davidg5678/HP-Prime-IPS-LCD-Mod-FPGA/PROGRESS.md

# Progress

Update this file at the end of each work session so a future session (human or agent) can
pick up cold. Newest entries at the top.

## 2026-08-07 — BACKLIGHT DIMMING WORKS. The "PWM dimming is impossible" claim was wrong.

**Status: observed on hardware — at 200 Hz the backlight dims smoothly across the entire sweep,
duty 255 down to 8, and looks good at every level.** User's words: *"Dimming works and looks good at
all levels, but panel never goes completely dark; it just gets pretty dim."* No flicker reported.

```
make pass-hw BLHZ=200 SWEEP=1

 duty     %   on-time          observed
  255  100%    4988 us         bright
  128   50%    2503 us         |
   64   25%    1251 us         |  smooth, good at every step
   32   13%     625 us         |
    8    3%     156 us         dim, still lit
```

### What this overturns

Three documents carried "**PWM dimming does not work on this board**", derived from a single
measurement: 1 kHz, 25% duty, dark. That is now definitively false as a statement about the board.
The frequency was never the fixed thing — it was just never varied.

The cost of the original phrasing was real: it made `BL_DUTY_INIT` a binary choice between 0 and
255 for two sessions, and produced a shipped default that powered the box up dark.

### And it leaves a contradiction, recorded rather than explained away

The model that justified the fix was *minimum usable duty ≈ soft-start / period* — lengthen the
period and the on-time clears soft-start. **The data does not support that model.**

```
FAILED (2026-08-04):   1 kHz, 25% duty  ->  250 us on-time  ->  dark
WORKS  (2026-08-07):   200 Hz, duty 8   ->  156 us on-time  ->  lit
```

**The working case has a SHORTER on-time than the failing one.** So on-time versus soft-start cannot
be what distinguishes them. Either some other variable does — off-time, the converter's shutdown
behaviour between cycles, C54's discharge through a non-linear LED string — or the original
observation was mistaken. That session was the same one that fixed the reversing FFC and had a
misread meter, so a bad reading is not implausible.

**The re-test at 1 kHz was attempted and did not run** (`make pass-hw BLHZ=1000 SWEEP=1` — the board
had been disconnected). It is a 30-second experiment and it is the single thing that would settle
this. Do it before writing any explanation into the docs; the whole point of this entry is that the
last explanation was written from one data point and was wrong.

### Open, in priority order

- **Re-run the 1 kHz sweep.** Resolves the contradiction above. If 1 kHz now dims fine, the original
  observation was simply wrong and the frequency control is a convenience rather than a fix. If it
  is genuinely dark, there is a real frequency threshold worth finding by bisection.
- **`BL=0` full-off is not observed.** The sweep stops at duty 8. The RTL forces the pin low when
  `bl_duty == 0` (`bl_on = bl_ready && (bl_duty != 8'd0)`), so it should be a true off, but "should
  be" is what this entry is about. One command confirms it.
- **The low end is coarse and perceptually uneven.** Duty is 8-bit, so the bottom of the range steps
  8 -> 4 -> 2 -> 1 in ~doubling jumps of *perceived* brightness, since perception is roughly
  logarithmic. Two independent improvements: widen the PWM duty to 12 bits for resolution near
  zero, and apply a gamma curve (host-side is enough — map a 0..255 user level through
  `(level/255)^2.2`) so equal control steps feel equal. This is what would turn "good at all levels"
  into even control.
- **LED current is STILL unmeasured**, now at every duty. The panel wants 19.2 V at 40 mA, abs max
  50 mA. Dimming makes the design safer, not verified.
- Analog dimming via an RC-filtered PWM into the `FB` node stays available as a hardware option, but
  on this evidence **it is not needed** — which was the question worth answering before designing a
  PCB around it.

## 2026-08-04 (part 3) — full frame rate, a 19x faster sim loop, and an FPGA playbook

**Status: the standalone box is finished. Flashed, boots into the live passthrough by itself with
the backlight on, at the FULL source rate.** `make pass-hw` →
`PASS: passthrough emitting 320x240 in 371x260 at 62.2 Hz (62.2 fps wall-clock); source 320x240 at
37.3 fps, LIVE PASSTHROUGH on the panel`. New: `make simq` (Verilator), `sim/targets/passthrough_slow`,
`docs/fpga_project_playbook.md`, triple buffering.

### Verilator: the inner loop got 19x faster, for free

`verilator --binary --timing` compiled `tb_passthrough` **first try**, no source changes, only
`-Wno-fatal` to get past pre-existing lint warnings. `#delay`, `fork`/`join`, `wait()`, hierarchical
`dut.x` references, the tristate SDRAM bus and `$fatal(1)` all worked.

```
iverilog + vvp        4 m 29 s
verilator --binary        14 s      <- identical verdict, 47/47 checks
```

`make simq` is the new inner loop; **`make sim` keeps its meaning unchanged** as the reference. Both
are kept deliberately, for the reason `CLAUDE.md` already gives about iverilog vs GowinSynthesis:
independent tools disagree about what legal Verilog is, so their *agreement* is evidence. Same
argument as `make build-oss`.

This single change is what made everything below affordable — the slow-regime testbench that found
the buffering bug is 350 ms of simulated time, which is minutes under Icarus and seconds under
Verilator.

### The verification gap closed, then the bug fixed

`sim/targets/passthrough_slow` runs the source at the Prime's **real frame rate** (1361 DOTCLKs ×
259 lines = 26.53 ms = 37.70 Hz) with reduced active height — the opposite trade from the sibling
testbench, which keeps real line timing but ends up running the source ~5x FASTER than the panel.

Written to assert the behaviour **wanted**, not the behaviour produced, so it failed first:

```
source emitted 6 frames, DUT captured 3
FAIL: captured 3 of 6 source frames (50.0%)
```

That is the hardware bug, reproduced in 33 seconds, having previously needed a calculator, a panel
and a host wall-clock to notice.

**Fixed with a third buffer.** Three roles — `rbuf` on screen, `wbuf` filling, `dbuf` complete and
pending — with a three-way rotation when both frame boundaries land on the same clock, which the
two-buffer design could prove impossible and this one cannot. `wr_active` now never clears once
armed: the writer always has somewhere to go.

Measured on hardware: **18.9 fps → 37.4 fps.** Every source frame captured.

The old invariant (`wr_active` and `wdone` never both set) was retired with the scheme it described.
Worth noting it **held perfectly** right up to the moment hardware showed half the frames were being
dropped — a true invariant is not the same as a sufficient one. Its replacement is stronger:
`rbuf`, `wbuf` and (while pending) `dbuf` are always three distinct buffers, asserted every clock in
both testbenches.

### The timing margin was luck, and the build gate proved it

Adding the third buffer **failed the build**: 3 violated setup endpoints, Fmax 105.2 MHz against a
108 MHz constraint. All three violations were the path flagged in part 2 — the horizontal counter
through `test_pattern`'s combinational logic into the output register. Diagnostic scaffolding was
setting Fmax for the whole design.

Fixed by fencing `test_pattern` with registers on **both** sides. Free, because its output is
sampled only on `tg_tick`, one cycle in eighteen; and safe for a reason worth stating rather than
assuming — `tick` is a one-cycle pulse at the last phase and `nxt_x`/`nxt_y` change only just after
it, so they are stable for the 17 cycles preceding every tick.

```
two buffers, no pipeline     108.423 MHz    (36 ps -- placement noise)
three buffers, no pipeline   105.172 MHz    BUILD FAIL, 3 violations
three buffers, output reg    108.677 MHz    passes, 0.6% margin -- still luck
three buffers, both sides    117.721 MHz    9% margin, logic depth 8 -> 6
```

Registering only the output was not enough: it split the path but left the counter→pattern half
still setting Fmax. **`make build`'s timing gate is the only reason any of this was noticed** — the
vendor tool exits 0 and writes a bitstream regardless.

### `docs/fpga_project_playbook.md`

A board- and vendor-agnostic distillation of everything this project learned, written to be copied
into a new repo: layout conventions, the PASS/FAIL contract, the two-simulator strategy, the
runtime-mux convention and how to choose its power-on default, build gating, telemetry design, the
classes of board trap that cost time here, debugging discipline, and how to work with an agent on
hardware. `docs/verification.md` remains the project-specific version of the same argument.

### Backlight: 0 → 255, and why the earlier reasoning was incomplete

Part 2 set `BL_DUTY_INIT = 0` to avoid enabling a boost into a load that cannot be detected. Correct
for `lcd_panel`, a bench tool where panels come and go — but it meant the flashed box **powered up
dark and needed a computer to light it**, defeating the point.

The step missed the first time: **pin 49 has a 27 kΩ pull-up, so the boost is already enabled by
every bitstream that does not drive that pin**, including an unconfigured FPGA. "Boost on" is the
board's resting state; 255 just reaches it deliberately, and 250 ms after video starts per the
panel's T2. Now `8'd255`, and the testbench asserts the shipped value is never in the **forbidden
1..254 range** — the range that produces a dark panel reporting itself lit.

### Three testbench bugs, all one class

All three were **comparing quantities that live on different time bases**, and all three produced
failures while the RTL was correct:

1. `dut.mode_real` point-sampled after a pin-observed frame count — internal state changes cycles
   before the pins show it. Fixed by accumulating over the window the pins define.
2. A pixel-check window opened mid-frame and closed at the next VSYNC, so it could land entirely in
   blanking: `0 pixels checked` while everything else passed. Fixed by aligning to a boundary first.
3. Source-frame counters compared across the sampler's lag, giving `7 of 6` and then `6 of 5` —
   *opposite* directions, the signature of a window straddling a boundary. Fixed by reading both
   counters 1 ms after a boundary, far outside the lag and far inside a frame.

### Open

- The **two-buffer** rate limitation is fixed; nothing known is outstanding on the passthrough.
- `sim/targets/passthrough` still runs the source faster than the panel. That is now a deliberate
  division of labour with `passthrough_slow` rather than an oversight, and both are documented as
  such — but note that neither runs a *full-height* source, so the writer still only addresses
  `y < 8`.
- The RGB LED cannot be silenced (pin 79 is `probe[8]`); the LED row defaults on where `lcd_panel`
  defaults off. Both cosmetic.
- `python/tools/lcd_panel.py`'s docstring still claims 25% PWM default — stale since Phase 3.

## 2026-08-04 (part 2) — PHASE 4 COMPLETE: the HP Prime's screen is live on the replacement panel

**Status: the passthrough works on hardware, first attempt, no debugging session. The calculator's
display is reproduced on the Orient Display AFY320240A0 in real time, entirely inside the FPGA —
the host is not in the video path at all.** `make pass-hw` →
`PASS: passthrough emitting 320x240 in 371x260 at 62.2 Hz (62.7 fps wall-clock); source 320x240 at
18.9 fps, LIVE PASSTHROUGH on the panel`. Visually confirmed: "the prime's screen is showing and
looks perfect."

**All four phases are now done.**

New this session: `python/tools/passthrough.py`, `make pass-hw`, AUTO mode, report v0x07.
`make sim SIM_TARGET=passthrough` → PASS, 43 checks. `make build BUILD_TARGET=passthrough` →
5524 paths, 0 setup / 0 hold, Fmax 111.0 MHz. `make build-oss` agrees.

### It worked first time, and the reason is worth naming

Nothing was debugged on hardware. Every question that *could* have been settled in simulation had
been, and the two that could not — is the panel wired correctly, is the calculator's flex actually
driving — had both been settled in earlier phases by the same discipline. The bring-up was three
commands and a look at the glass.

That is the payoff `docs/verification.md` argues for, measured: the phase that had the most moving
parts (capture + SDRAM + panel + rate matching + a runtime mux) cost the least hardware time of any
in the project, because the RTL arrived at the bench already correct.

The one thing simulation could not have caught was also the one thing that would have looked like a
hardware fault: `BL_DUTY_INIT = 64`, which produces a **dark panel while the report says the
backlight is on**. That was found by re-reading Phase 3's own PROGRESS entry rather than by any
tool. Fixed before first flash. **Use `BL=255`.**

### Two measurements taken at the bench, one benign and one real

**Runts: 26,933 — benign, and only after doing the arithmetic.** Over ~81 s the Prime emits
~1.08 x 10^9 DOTCLK edges, so that is **0.0025%**, roughly 15x *better* than the 130-per-frame rate
Phase 2 measured with `frame_capture`. A raw counter means nothing without its denominator, and
this one is alarming-looking on purpose-built display. Left as-is.

**Source frame rate is 18.9 fps against the Prime's 37.7 Hz — exactly half, and this one is real.**
Caught only because `passthrough.py` times the FPGA's own counter against host wall-clock; the
FPGA's internal view is perfectly self-consistent at 18.9.

Cause is architectural, not a coding slip. `ev_done` fires at the same instant as the *next* source
frame's `frame_start`. At that moment **both** buffers are occupied — one just filled and awaiting
the panel swap, one being displayed — so the writer cannot arm for the frame beginning right then,
and re-arms one frame later. It therefore captures every *other* source frame.

**This contradicts this file's own earlier claim that two buffers suffice.** That argument — "a
completed capture is always collected before the writer needs the buffer back" — is subtly wrong:
the writer needs a buffer *at the instant* the previous capture completes, which is necessarily
before any panel swap can have occurred. Reader-faster-than-writer makes the *collection* safe; it
does not make a buffer *available* at the frame boundary. Capturing every frame needs a **third
buffer**, and the SDRAM has room to spare (8 MB total, 150 KB per buffer).

Not a visible defect: the panel still refreshes at 62.2 Hz so there is no flicker, only the content
updates at 18.9 Hz, which a calculator UI does not stress. But it is half the available fidelity,
it was asserted to be otherwise, and simulation could never have found it — the testbench runs the
source *faster* than the panel, the inverse regime, where this effect does not arise.

### The design goal was restated, and it changed the default

The passthrough is meant to be a **standalone box**: calculator in, panel out, no computer. The
bitstream as written could not be one. `CLAUDE.md`'s mock-mode convention defaults the mux to MOCK
at power-on, so a flashed board would sit on a test pattern forever unless a host sent `0x52`.

**New third setting, `AUTO` (`0x41` = 'A'), and it is now the power-on default.** Mock pattern until
a captured frame has been *swapped* to the reader, then live passthrough, and it stays there. Forced
MOCK/REAL still override absolutely, so the convention's actual content — both paths in one
runtime-switchable bitstream — is untouched. Only the default moved.

AUTO also beats defaulting to plain REAL, and the reason is diagnostic rather than aesthetic:

| Calculator not driving | What you see | What you can conclude |
|---|---|---|
| default REAL | black panel | nothing — dead bitstream, unseated FFC, backlight at 0 and "no signal" are identical |
| **default AUTO** | **GRID pattern** | **FPGA, FFC, panel and output path are all good; only the calculator is missing** |

Two implementation details that mattered more than the feature:

- **It gates on `have_frame`, not `src_frames`.** `src_frames` counts frames the *writer* finished,
  one of which may still sit unswapped in `wbuf`. Switching on that would present a buffer the panel
  has not been handed. `have_frame` is set at `ev_swap`, so it means the *reader's* buffer is
  complete.
- **The effective mode is latched at the panel's frame boundary**, like the swap itself, so the
  changeover cannot tear a frame. That also buys a free frame of margin: `ev_swap` sets `have_frame`
  on a `tg_frame` edge, so the latch samples the pre-swap value on that edge and flips at the *next*
  one, by which point the reader has streamed the new buffer for a whole frame.

Cost: **3 registers and 2 LUTs.** The double-buffer machinery already existed; AUTO only gates it.

### A regression caught by reading Phase 3's own lesson back

`passthrough_top.v` shipped `BL_DUTY_INIT = 8'd64`, written the session *before* Phase 3 reached
hardware. `lcd_panel_top.v` was corrected to `8'd0` *by* that session. So Phase 4 still carried the
exact failure Phase 3 had already paid for: at 25% duty the LP3320 never clears soft-start, the
panel stays dark, **and the status report says the backlight is on**. First light would have looked
like a hardware fault.

Now `8'd0`, with the reasoning in the parameter comment so it does not get "helpfully" raised again.
The testbench reads the shipped duty back **off the wire** (`rpt[4] == 0`) rather than asserting
about the source, and deliberately does *not* override that parameter the way it overrides
`BL_DELAY_CYCLES`. **Use `BL=255`; intermediate values do not work on this board.**

### A testbench bug that failed while the RTL was right

One check failed: `effective mode still MOCK = 1, expected 0` — alongside `pixel mismatches = 0`
over all 76,800 pixels against the GRID oracle. Both readings were true, which is what made it
diagnosable: the frame displayed *was* mock, and the sample was taken late.

Cause: a point-sample of `dut.mode_real` taken after `wait (frames == f0+1)`. `frames` counts VSYNC
edges observed at the **pins**; `mode_real` is latched on the timing generator's **internal** frame
tick a few cycles earlier. **This is the same pin-versus-internal skew the testbench's own comment
already documents for `ev_swap`** — and it was reintroduced anyway, three months of notes later.

Fixed by not point-sampling at all: two sticky flags accumulate which effective mode was in force
while `lcd_de` was high, so the assertion covers every *displayed* pixel of the frame. That removes
the skew rather than compensating for it, and it is a stronger claim — a mode that flipped mid-scan
would now be caught too.

### Fmax moved 108.423 → 111.020 MHz *because logic was added*

Which cannot be a real speedup, and is the useful part. The critical path moved from
`u_tg/hc[10] → lcd_r[0]` to `u_tg/vc[5] → lcd_g[0]`, depth 8 → 7. Both are the **mock test
pattern's** combinational logic — diagnostic scaffolding — reaching the output register in one
cycle.

So the previous build's 36 ps of slack was **placement noise, not a structural limit**, and neither
number is a dependable margin: this design sits around 108–111 MHz with ~3% run-to-run variation
against a 108 MHz constraint. A future build that changes nothing could land at 108.0 and fail.
`test_pattern`'s output is only consumed on `tg_tick`, once every 18 cycles, so **a pipeline
register would take it off the critical path permanently** instead of leaving it to the placer.
Not done yet — recorded so the next timing surprise is not treated as new.

### `python/tools/passthrough.py` + `make pass-hw` — control and telemetry only

**It carries no pixels, and it is not needed for normal use.** Phase 2's UART streaming is retired,
not unfinished: it topped out at 2.0–2.6 fps because the ceiling was per-request latency, not bit
rate. The video path is internal and the host is not in it.

The tool exists for when AUTO *doesn't* light up, because the 24-byte report separates faults that
look identical on the glass. Report version bumped **0x06 → 0x07**: byte 5 now carries the
*requested* mode plus `have_frame`, while bit 2 of byte 2 carries the *effective* mode. Those two
disagreeing is the single most useful reading in the report — "requested AUTO, effective MOCK,
have_frame 0" means the calculator is not driving, which is a different fault from "effective REAL
with 0 source frames".

It also cross-checks the FPGA's frame counter against **host wall-clock**, the two-instruments
argument from `docs/prime_lcd_protocol.md`: a mis-locked PLL still produces self-consistent 371×260
frames, and only an independent clock catches that. Source-side geometry is **reported but never a
pass criterion**, so the tool still passes on a bench with no calculator attached — which is the
first bring-up step.

### Build health

- Gowin signoff: **5524 paths, 0 setup / 0 hold.** Logic 1386/20736 (7%), Register 895 (6%),
  **42/66 package I/O**, 1 rPLL, **0 BSRAM** (the three FIFOs went to logic).
- Setup analysed at **Slow 0.95 V 85 °C** — the worst-case corner, so the margin is real, if thin.
- Pins 88 (`MODE0`), 87 (`MODE1`) and 9 (`RECONFIG_N`) carry no signal. The four SSPI pins
  (53/54/55/56) *are* in use, which is exactly what `options.tcl` exists to allow.
- Four warnings, all read. Two are the documented pair (`PR1014` on `clk_d`, `NL0002` sweeping
  `test_pattern`). The other two are new and both correct:
  - `CV0018 probe[1] unused` — HSYNC, which `prime_pixel.v` documents as unused.
  - **`CV0020 probe[5:4] unused` — D0 and D1 of the Prime's bus.** RGB565 truncation drops red's
    bottom 3 bits, green's bottom 2 and blue's bottom 3, so D0 and D1 fall below *every* threshold
    and cannot reach any output. D2 survives only through green, which is why `probe[6]` is not in
    the warning. **The toolchain rediscovered the board's RGB565 wiring from the RTL alone.**
    Those two probe wires must stay physically connected regardless — `la_capture` and
    `frame_capture` share the harness and do use all 8 bits.

### Timings, for whoever optimises the loop next

`make build` is **8.9 seconds**. `make sim SIM_TARGET=passthrough` is **4 m 29 s**. The simulation
is ~34.5 M clock cycles at ~128 k cycles/s, which is ordinary `vvp` interpreter speed, and the cost
scales with *simulated time*, not with how many pixels are checked — each panel frame is 16.08 ms
= 1.7 M cycles ≈ 13 s of wall clock whether or not anything inspects it. Levers, in order of size:
Verilator `--binary --timing` (10–50×, already installed, untried); trimming settling waits (~30%);
splitting the testbench into a fast inner-loop target and a slow signoff one.

### Open

- **The passthrough captures every OTHER source frame (18.9 Hz, not 37.7).** Needs a third buffer;
  see above. Highest-value remaining change, and the SDRAM has the room.
- **The testbench runs the source FASTER than the panel — the inverse of reality.** Eight active
  lines in a 30-line frame repeats at ~325 Hz against the panel's 62.2 Hz, where the real
  calculator is 37.7 Hz. That exercises the frame-*dropping* path hard, which is the stricter
  direction for the swap invariant, but it means "two buffers suffice because the reader is
  strictly faster" is still **argued rather than demonstrated**. A second phase with
  `P_V_TOTAL ≈ 195` (a ~20 ms source frame, slower than the panel's 16.08 ms) would enter the real
  regime for ~60 ms of extra sim time. The PASS line previously claimed "37.7 Hz-class timing",
  which was true of the *line* and false of the *frame*; it now states the geometry it actually ran.
- **The writer only ever addresses `y < 8`.** Full-height addressing (`row_base` near `y = 239`) is
  arithmetically checked — 38,240 + 159 = 38,399 against `FB_WORDS` 38,400 — but never exercised.
- Fmax is placement-dependent at ~3% against a 108 MHz constraint; see above.
- The RGB LED **cannot** be silenced here (pin 79 is `probe[8]`), unlike `lcd_panel`. Expect it lit
  at some arbitrary colour; it is not a fault.
- The LED row defaults **on**, where `lcd_panel` added `CMD_LEDS` (`0x4C`) to default it off. Not
  ported.
- `python/tools/lcd_panel.py`'s docstring still claims the bitstream "comes up at 25% PWM duty" —
  stale since `BL_DUTY_INIT` went to 0 in Phase 3.
- **Consider `make flash BUILD_TARGET=passthrough` once it works on hardware.** Every power cycle
  currently reverts to `la_capture` in flash, which leaves pin 49 undriven and the backlight boost
  enabled by the board's pull-up. Persisting a bitstream that actively drives that pin makes the
  safe state the default — and makes the standalone box actually standalone.

### The bring-up sequence that worked — reuse it

```
make flash-sram BUILD_TARGET=passthrough
make pass-hw MODE=mock BL=255   # panel only: is Phase 3 intact inside the
                                # bigger bitstream? -> 371x260 @ 62.2 Hz, and
                                # src_frames was ALREADY climbing with
                                # 240 lines / 320 px, so the capture side was
                                # confirmed before the mux was ever switched.
make pass-hw MODE=auto          # hand control back -> effective mode REAL,
                                # reached without forcing. Prime's screen on
                                # the glass.
```

Forcing MOCK first is what made this three commands instead of a debugging session: it separates
"is the FPGA driving the panel correctly?" from "is the calculator driving?" **before** the two are
composed, and the report answers the second question while the panel is still showing the first.
That is the entire reason the capture path runs in both modes.

## 2026-08-04 — PHASE 3 COMPLETE: the panel is displaying

**Status: the physical Orient Display AFY320240A0 is lit and showing all eight test patterns at
320×240, driven from `src/targets/lcd_panel`. `make lcd-hw` → `PASS: lcd_panel emitting 320x240 in
371x260 at 62.2 Hz`.** Phase 3 is done.

### What fixed it, and what that confirms

A **reversing (type A ↔ type B) 40-pin 0.5 mm FFC**. Nothing in the FPGA changed. That was the one
pre-flight check `docs/panel_afy320240a0.md` had flagged as impossible to settle from the schematic,
and it was the only thing wrong.

Because the whole signal chain now works end to end, a lot is confirmed at once that could not be
checked any other way:

| Confirmed by the panel actually working | Would have failed how |
|---|---|
| Bit order across the connector (descending pin number as vector index ascends) | plausible-looking wrong colours |
| RGB565 channel wiring, all three channels | swapped or dead channel on BARS |
| DE gating and the 320×240 active window | missing border line on GRID |
| Thbp = 43 with Thw nested inside it | image sitting 4 px off |
| **DCLK polarity — the quarter-period phase offset works** | corrupt pixels, or smear on CHECKER |

That last row is the one worth dwelling on. The datasheet's polarity could not be read off the
scanned figures and `DPOL` is unreachable because the board grounds the panel's CS. Rather than
guess, `lcd_timing_gen` places DCLK's edges 4 and 13 phases from the data transition so the design
is correct on *either* edge. It works, and it would have worked had the polarity been the other way.

### The backlight PWM does not work, and now we know why

**Measured, from both directions.** The LP3320's enable is PWMed at ~1 kHz, so 25% duty is a 250 µs
on-time — shorter than the converter's soft-start. It never reaches regulation and the panel stays
dark **while the status report says the backlight is on**, which is the worst combination.

Both ends of the evidence:

- It lit immediately when the board reverted to `la_capture`, a bitstream that does not drive
  pin 49 at all — leaving the board's 27 kΩ pull-up to hold `EN` statically high.
- It lights at `BL=255` (99.6% duty, effectively static).

So `BL=255` is the working setting, and `BL_DUTY_INIT` stays 0: a default that reports "on" while
producing no light is worse than one that reports off. Restoring dimming means raising
`PWM_PRESCALE` until the on-time comfortably exceeds soft-start (~200 Hz gives 1.25 ms at 25%), then
walking the duty down on hardware to find where it drops out. **Left unchanged rather than altered
on a guess** — the LP3320 datasheet would settle it properly.

### Open

- **Phase 4** (`src/targets/passthrough/`) is the remaining work: written, passes simulation end to
  end, never synthesised. Now unblocked — the panel it drives is known good.
- Backlight dimming, as above. `BL=255` works; intermediate values do not.
- Consider `make flash BUILD_TARGET=lcd_panel` to persist. Every power cycle currently reverts to
  `la_capture` in flash, which leaves pin 49 undriven and the backlight boost enabled by the
  board's pull-up. Persisting a bitstream that actively drives that pin makes the safe state the
  default.
- LED current is still unmeasured at `BL=255`. The panel wants 20–40 mA, abs max 50 mA.

## 2026-08-03 (part 5) — PHASE 3 ON HARDWARE: FPGA side confirmed. Panel dark — A/B FFC mismatch.

**Status: `make lcd-hw` → `PASS: lcd_panel emitting 320x240 in 371x260 at 62.2 Hz`, on real
silicon, first flash. The panel itself displays nothing, and the cause is now known and is not in
the FPGA: the panel's FFC and the Tang Nano's J2 are opposite contact types (A vs B), confirmed
with a multimeter. Fix is a reversing 40-pin 0.5 mm FFC.**

### The FPGA side is right, measured two independent ways

```
h = 320/371   v = 240/260        exactly the datasheet typical column
line 61.8 us (spec 55-65)        frame 62.2 Hz (spec ~58-68)
measured 62.8 fps over 0.51 s    <- host wall-clock, independent of the above
```

The last line is the one that matters. 62.2 Hz is *derived* from edges the FPGA counted on its own
output pins; 62.8 fps is timed by the host against real time. A mis-locked PLL or a miscounting
phase generator would still produce self-consistent 371x260 frames — only comparing against
wall-clock catches it. Same two-instruments argument `docs/prime_lcd_protocol.md` uses for the
Prime's frame rate.

### The pre-flight check that mattered was the one flagged as unverifiable

`docs/panel_afy320240a0.md` listed three checks needing eyes on hardware, first among them FPC
contact orientation, with the note that it "cannot be settled from the schematic". That is exactly
what failed. Nothing else was wrong.

### Three things learned about the board, all of them traps

- **Pin 49 (backlight enable) has a 27 kΩ pull-up to +3V3 on the board** (R29), with the FPGA
  driving through R30 = 100 Ω. So the LP3320 boost is **enabled by default** and only an actively
  driven low turns it off. `PULL_MODE=DOWN` in a `.cst` does not help — an internal ~50 kΩ pulldown
  loses to an external 27 kΩ pull-up. **Any bitstream that does not drive pin 49 leaves the
  backlight converter enabled**, including `la_capture`, `frame_capture` and an unconfigured FPGA.
- **The onboard WS2812 latches its colour and holds it.** Leaving pin 79 unassigned lets the data
  line float, pick up noise and latch some arbitrary bright colour; tying it low does not clear it,
  because a permanently low line is just an endless inter-frame gap. The only fix is to *send* 24
  zero bits — hence `src/common/ws2812_off.v`. **Pin 79 is also `probe[8]` (the Prime's D4)**, so a
  capturing target cannot silence this LED.
- **A status report of `a5 02 …` in 10 bytes means the board reset.** SRAM configuration is
  volatile, and the onboard flash still holds `la_capture` (report version 0x02, 10-byte header)
  from an earlier session. Any power blip silently swaps the running design for that one, and the
  symptom is a truncated reply rather than a dead link. Free diagnostic; worth knowing.

### Changes made

- `src/common/ws2812_off.v` — continuous zero frames, holds the RGB LED dark.
- Status LED row now **defaults off**, runtime-switchable with `0x4C 'L'` (`make lcd-hw LEDS=on`).
  `leds[0]` keeps its ~1.6 Hz heartbeat unconditionally: `docs/verification.md`'s argument for a
  liveness indicator is that it must work when the serial link does not, and an all-dark board
  cannot be told apart from an unconfigured one.
- **`BL_DUTY_INIT` changed from 64 to 0 — the backlight is now opt-in.** The original reasoning
  ("start dim, it is the cheap direction to be wrong in") missed the case where no panel is mated:
  the LP3320 takes its feedback from R31 in series with the panel's LED string, so with no LED
  current FB never reaches threshold and the converter drives to maximum into an open circuit.
  A display driver must not enable a boost into a load it cannot detect, and nothing on the 40-pin
  connector reports back. The testbench pins the shipped default at 0 while overriding it to 64 so
  the PWM duty measurements still have edges to measure.

### Two wrong turns, recorded because both cost time

- **A truncated status reply was diagnosed as a brownout caused by the backlight.** It was not —
  the board had been power-cycled manually between trials and had reconfigured from flash. The
  reading that settled it was the raw reply bytes (`a5 02 30 …`), not any amount of reasoning about
  boost converters. Dump the bytes first.
- **A misread meter (2.66 A, actually 2 W ≈ 400 mA) triggered a damage scare and an emergency
  power-down.** Nothing was damaged. The arithmetic that should have been done immediately: all six
  indicator LEDs plus a full-white WS2812 come to ~0.12 A, so LEDs could never have explained
  2.66 A — but they explain 400 mA fine.

### Can the FFC mismatch be fixed in software, or worked around with jumper wires? No, and partly.

Both asked and both answered from the datasheet's Pinout diagram (page 5), now recorded in
`boards/tangnano20k/pinout.md`.

**Flipping in software is impossible**, and for a power reason rather than a signal one. A flipped
cable mates board pin *N* with panel pin *41−N*, which lands the panel's VDD on FPGA pin 15, its
19 V backlight anode on FPGA pin 17, and its ground on FPGA pin 38. A `.cst` can reassign which pin
carries which *signal*; it cannot make an I/O pad supply a rail.

**Jumper wires from the headers are possible but constrained.** The headers expose 34 free IOs, 31
usable after excluding the three BL616 pins. But **the entire green channel (32–37) and the top
three red bits (38/39/40) are not on the headers at all** — they exist only at the FFC socket, so
other header IOs would have to be reassigned to them. Full RGB565 + sync + backlight is 25 of 31,
which leaves too few for Phase 4's twelve probes; RGB444 fits both. And `VLED+`/`VLED-` are *only*
at FFC positions 1/2, so a header-wired panel has no access to the board's 19 V boost and needs an
external constant-current driver. `3V3` and `GND` are on the headers, so panel VDD is fine.

Conclusion: the reversing FFC is the cheaper and strictly better fix — it keeps 16-bit colour, the
onboard backlight supply, and Phase 4's probe budget.

### PHASE 4 also landed this session: `src/targets/passthrough/`

Written and passing simulation end to end, **not synthesised and not run on hardware**, parked
behind Phase 3's panel. New: `src/common/prime_pixel.v`, `src/targets/passthrough/`,
`sim/targets/prime_pixel/`, `sim/targets/passthrough/`.

```
PASS: passthrough -- 320 x 8 source pixels captured from a 1361-DOTCLK line at 37.7 Hz-class
timing, buffered in SDRAM and re-emitted exactly on 371 x 260 panel timing at 62 Hz, mux verified
in both directions, 0 overruns, 0 underruns
```

- **`prime_pixel`** turns `dotclk_sampler` output into addressed RGB565 pixels, resetting the
  component phase on the DE rising edge. Its unit testbench decodes a full 320×240 frame at real
  Prime timing — 76,800 pixels, 0 value errors, 0 coordinate errors, 0 runts — in 5 s, using
  Phase 1's `video_timing_gen` as an independent implementation of the protocol.
- **Double buffering exchanges at the panel's frame boundary**, so no frame tears. Two buffers
  suffice *only* because the panel (62.2 Hz) is strictly faster than the calculator (37.7 Hz);
  the invariant that encodes this (`wr_active` and `wdone` never both set) is asserted on every
  clock rather than reasoned about once.
- **Rate budget: 1.45 MW/s writer + 2.39 MW/s reader = 3.84 of ~10.8 MW/s.** No burst mode needed,
  which is the measurement `docs/sdram.md` asked for before optimising.
- Buffers sit in different SDRAM *banks* (stride 2^19) — irrelevant to today's single-word
  controller, but it is the layout an open-row policy would need.
- An in-flight SDRAM read is explicitly discarded across a frame restart (`rd_discard`). That is
  the exact class of bug left open in Phase 2's `frame_stream`, so it was handled rather than
  assumed away.

### Open

- **Waiting on a reversing (type A ↔ type B) 40-pin 0.5 mm FFC.** Everything else is ready.
- The PWM-on-a-boost-enable question is still unresolved: at 25% duty / 1 kHz the on-time is 250 µs
  and the LP3320's soft-start is unknown, so "dim" may simply not be reachable. Untested — the one
  full-duty trial ran into an open circuit, which proves nothing about the loaded case. The LP3320
  datasheet (FB reference, soft-start, current limit, OVP) would settle both this and what current
  R31 = 5.6 Ω actually sets.
- Phase 4 (`src/targets/passthrough/`) is written and passes simulation end to end — Prime →
  SDRAM → panel, 0 overruns, 0 underruns — but is **not synthesised and not run on hardware**, and
  is parked until the panel is confirmed working. Note it cannot silence the RGB LED (pin 79 is a
  probe there).

## 2026-08-03 (part 4) — PHASE 3: panel driver written and verified in simulation. No hardware yet.

**Status: `make sim SIM_TARGET=lcd_timing_gen` and `SIM_TARGET=lcd_panel` both PASS; `make build
BUILD_TARGET=lcd_panel` → 2201 paths, 0 setup / 0 hold; `make build-oss` passes. All eight
simulations in the repo pass. NOTHING HAS BEEN RUN ON THE PANEL — it was not connected during this
session.** New: `src/common/lcd_timing_gen.v`, `src/common/test_pattern.v`,
`src/targets/lcd_panel/`, `sim/targets/lcd_timing_gen/`, `sim/targets/lcd_panel/`,
`python/tools/lcd_panel.py`, `make lcd-hw`.

### Why Phase 3 now, ahead of finishing Phase 2's streaming

The decision was made on bandwidth. Streaming frames to the host maxed out at 2.0–2.6 fps at
1 Mbaud even after 4.6x RLE, and the measurements in part 3 showed the ceiling was per-request
latency, not bit rate — raising the baud rate to 3 Mbaud made it *worse*. The internal path is
108 MHz x 32 bits = 432 MB/s. Static captures already prove the protocol is understood
(`docs/prime_lcd_protocol.md` is complete and every figure in it is measured), so the remaining
value is in the passthrough, which never touches the host.

**This defers the "frames after the first are partial" bug rather than fixing it.** That bug is in
the capture re-arm path, not in the UART — the evidence in part 3 rules out host decoder speed,
padding, VSYNC re-trigger and stale `fetch_pending`. Phase 4 re-arms per frame continuously, so it
is likely to resurface there. Recording it here so a future session does not assume the phase
change made it go away.

### Two numbers that were not in `docs/panel_afy320240a0.md` before

The datasheet's AC tables are **images**, so `pdftotext` returns nothing for them and the existing
panel analysis was derived from the totals. Reading pages 10–13 visually confirms every derived
figure and adds the two pulse widths:

| | Min | Typ | Max | |
|---|---|---|---|---|
| Thw (HSYNC pulse) | 2 | **4** | 43 | DCLK |
| Tvw (VSYNC pulse) | 2 | **4** | 12 | HSYNC |

The SYNC-mode diagram on p.11 also settles directly what the arithmetic had only implied: **Thbp is
measured from the HSYNC falling edge and Thw is nested inside it.** Same for Tvw inside Tvbp. Get it
backwards and the image sits 4 pixels off with no other symptom.

### The one real design decision: DCLK is phase-shifted a quarter period

Every timing figure in the datasheet labels the clock "DCLK (Negative Polarity)", but the figures
are low-resolution scans and which edge the panel latches on cannot be read off them with
confidence. Normally you would set DPOL over the SPI — which is unreachable, because the board
grounds the panel's CS pin and a command only latches on CS's *rising* edge.

Guessing is a coin flip with a catastrophic wrong side: data changing *at* the sampling edge
corrupts every pixel. So instead, data transitions at phase 0 of the 18-cycle DCLK period and the
clock's two edges sit at phases 4 and 13:

| | setup | hold |
|---|---|---|
| falling edge (phase 4) | 37.0 ns | 129.6 ns |
| rising edge (phase 13) | 120.4 ns | 46.3 ns |

The spec is 12 ns for both. The worst of the four is **3.1x** the requirement, so the design is
correct on either polarity, and duty stays exactly 50% against a 40–60% spec. This is only
affordable because 6 MHz is slow — one DCLK is 18 system clocks, so quarter-period granularity is
free. It would not work at 108 MHz.

### Four bugs, two in the RTL and two in the testbenches

1. **DCLK went out of spec at power-on.** With the phase counter held in reset, DCLK parked high
   and the first period after release was stretched by the full reset length — 203.7 ns measured
   against a 200 ns maximum, and the real power-on reset is 32768 cycles, so on hardware that first
   period would have been ~304 µs. Fixed by letting the phase generator free-run from
   configuration and resetting only the video counters; the anomaly becomes a long *line* at
   power-on instead, which is ordinary. Caught because the testbench records the **maximum** period
   as well as the minimum — checking only "the period is 166 ns" would have passed.
   Cost, documented in the module: DCLK toggling is no longer evidence the design is out of reset.
2. **The status report's "active DCLKs per line" was latched on blanking lines too**, so it read 0
   whenever the host's request happened to land during vertical blanking — a `make lcd-hw` that
   passes or fails on timing luck. It surfaced as "active DCLKs = 0" alongside a correct "active
   lines = 240", a contradiction that could only come from the latch condition rather than the
   counter.
3. **Testbench: the reply was read after the request was fully sent.** The FPGA turns a status
   request around in a few 108 MHz cycles, so the first reply start bit had already passed by the
   time the receiver looked for it. Fixed by forking the receiver before the request goes out.
   Worth knowing this is a host-side hazard too — pyserial's buffering hides it, which is why
   simulation was the cheaper place to find it.
4. **Testbench: the backlight duty window ended exactly on a falling edge**, and whether the
   accumulator process or the task's stop-measuring assignment ran first is undefined in Verilog.
   It reported exactly half the true duty — convincing enough to be mistaken for a real divide-by-2
   in the RTL. Fixed by walking edges inside a single process.

### Mutation-tested, per `docs/verification.md`

Five deliberate breaks, all caught, each with a diagnostic naming the actual fault:

| Mutation | Caught as |
|---|---|
| `DCLK_FALL` 4 → 1 | `worst setup = 9.260 ns` (spec 12) + duty out of range |
| `DCLK_RISE` 13 → 18 (edge lands on the data change) | `worst hold = 0.000 ns` |
| `H_FRONT` 8 → 7 | `Th = 370, expected 371` and `Thfp = 7, expected 8` |
| `H_SYNC` 4 → 43 (sync no longer nested in the back porch) | `Thw 43 is not nested inside Thbp 43` |
| `DCLK_FALL` 4 → 0 | degenerate — the comparison never matches, DCLK stops, watchdog fires. Not a useful mutation; replaced with the two above |

### Verification structure

Two testbenches, deliberately split:

- **`sim/targets/lcd_timing_gen`** — the AC table at full size, in the datasheet's own units: DCLKs
  between HSYNC falls, HSYNC falls between VSYNC falls. Nothing reads `hc`/`vc`/`ph` inside the
  DUT. 6 s.
- **`sim/targets/lcd_panel`** — everything *between* the modules: all 76,800 active pixels of a
  frame compared against an oracle written from `test_pattern.v`'s documented spec (not copied from
  its code), the bus asserted to be 0 outside DE, the command channel driven over a bit-banged
  1 Mbaud UART, and the status report cross-checked against what the testbench measured off the
  same pins. It also fires `CMD_RESET` **mid-frame** and re-checks the full geometry and all 76,800
  pixels afterwards — that is the only test of `lcd_timing_gen`'s deferred restart, which holds a
  restart request until the next DCLK tick precisely so the outputs never move at an arbitrary
  phase. 60 s.

The top-level testbench overrides `BL_DELAY_CYCLES` to something a simulation can afford, and then
asserts the *shipped* default is ≥ 250 ms via a second, deliberately-never-clocked instance — so
"shrunk for simulation" cannot quietly become "shrunk on hardware".

### Numbers

- Gowin signoff: 2201 paths, 0 setup / 0 hold. 719 logic (4%), 396 registers (3%), **30/66
  package I/O**.
- Every one of the 30 pins checked against the report's Function column: no `MODE*`, `DONE`,
  `RECONFIG_N`, `READY` or `JTAGSEL_N` among them.
- **All banks now report `BankVccio 3.3`**, where previous builds showed pins 25–42 as `LVCMOS18`.
  That confirms `boards/tangnano20k/pinout.md`'s claim that the 1.8 V reading was the tool's
  default for banks holding *no assigned I/O*, not the board.
- 18 output registers were placed in IOBs, which helps output skew for free.
- Two build warnings, both read: `PR1014` on `clk_d` (expected, documented, the 27 MHz hop into the
  PLL) and `NL0002` "module test_pattern is swept in optimizing" — module-boundary flattening, not
  logic removal; 719 LUTs is far more than a bare timing generator plus UART.

### Open — all of these need the panel physically attached

- **Nothing has been driven into a panel.** Everything above is simulation plus two clean builds.
- **DCLK polarity is still unknown**, and by design it does not matter. If pixels smear anyway,
  `DCLK_FALL`/`DCLK_RISE` in `lcd_timing_gen` are the two parameters to move.
- **DISP (connector pin 31) is hard-tied to +3V3 on the board**, so the datasheet's `T1 ≥ 10 ms`
  between internal reset and DISP is very likely violated. Commodity boards do this routinely. If
  the panel fails to initialise, cutting that trace and driving DISP from pin 52 — the one spare
  FPGA pin — is the first thing to try.
- **Backlight current is unmeasured.** The panel wants 19.2 V at 40 mA, absolute max 50 mA; the
  board's driver was designed for Sipeed's 4.3" panel. The bitstream comes up at 25% PWM duty
  deliberately. Measure on pattern 4 (WHITE) before raising it.
- **FFC contact orientation is unverified** — both connectors are 40-pin 0.5 mm, but the contact
  face needs eyes on the hardware. If it is wrong the fix is a flipped FFC extension, not an
  adapter.
- Phase 4 composes this with `frame_capture`: it will need `options.tcl` (the SSPI pins for the
  probes) and a frame buffer in SDRAM, and it inherits the part-3 partial-frame bug noted above.

## 2026-08-03 (part 3) — LIVE STREAMING: first complete frame streams, later frames partial

**Status: `make stream-hw` → `PASS: live stream, 8 frames decoded at 2.56 fps, 0 truncated`.
The first frame of every run is a complete 320x240 (76,800 px, 100%); subsequent frames arrive
but are partial. Root cause not yet found — see Open.** All seven simulations pass. New:
`src/common/pixel_rle.v`, `src/targets/frame_stream/`, `sim/targets/frame_stream/`,
`python/tools/frame_stream.py`, `make stream-hw`.

### Measurement decided every part of the design

| Question | Measured answer |
|---|---|
| Raise the baud rate? | **No.** 3 Mbaud gives 79 KB/s, 1 Mbaud gives 81 KB/s — per-request latency (~74 ms per 8 KB) dominates, not bit rate. Host also rejects >3 Mbaud outright. |
| Continuous push at 3 Mbaud? | **Loses 65% of bytes** — the FPGA outruns the host. At 1 Mbaud the FPGA is the slower party, so a continuous push cannot overrun and needs no flow control. |
| Compress? | **RLE gives 4.6x** on a real captured frame (230,400 → 49,864 bytes) because 74% of a real screen is one flat white. 0.43 fps → 2.0 fps. |
| Stream every frame? | **No — 19x too fast.** A frame arrives every 26.5 ms and takes ~500 ms to send, so frames are skipped and the compressed frame is buffered in SDRAM while it goes out. |

That last row is why the SDRAM had to exist before this could.

### Four bugs, all found in simulation, all off-by-one in shape

1. **RLE emit counter one step short.** A run is four bytes but the counter was 2 bits stepping
   3→2→1; the last step assigned both G and B and the `if` overrode the `case`, so **G was
   silently dropped from every run**. Three bytes went out where four were expected and the whole
   stream slid out of alignment.
2. **`busy` lagged the flush it was meant to cover.** `emit` is set by non-blocking assignment, so
   on the `frame_start` cycle it still reads zero; the consumer concluded the encoder was idle and
   moved on one cycle before the final run appeared. Lost the last run of every frame.
3. **Two writers to one FIFO slot in one cycle.** On the cycle the final byte completed a word,
   `bpos` still read 3 (its wrap is pending), so the "pad the partial word" branch fired *as well
   as* the packer. Verilog took the later assignment and replaced a correct word with a
   zero-padded one — exactly one wrong byte at the end of every frame. Padding now has its own
   state so `bpos` has settled.
4. **Host decoder was O(n²).** `del buf[:4]` per run on a bytearray, ~12,000 runs per frame. Fixed
   with an index. Necessary, but it was not the cause of the partial frames.

### A build that passed and a simulation that could not compile

Moving the VSYNC tracker introduced a use-before-declaration of `st`/`S_WAIT`. **GowinSynthesis
built it cleanly and produced a working bitstream; iverilog refused to elaborate it.** The same
divergence `CLAUDE.md` records for `WARN (EX3638)`, and a concrete reminder that a passing build
says nothing about whether the RTL is well formed. It was flashed and tested before the
simulation was re-run — the wrong order.

### Open

- **Frames after the first are partial** (100%, 76%, then 1–18%). They arrive in a burst rather
  than paced, so the second and later capture windows are collapsing rather than the data being
  lost in transit. Ruled out so far: host decoder speed (fixed independently, no change), an
  odd-length pad byte desynchronising the host (fixed, no change), re-triggering on the tail of
  the VSYNC pulse already in progress (guard added, no change), and stale `fetch_pending` carried
  from the send into the capture (cleared, no change). Next things to try: report `rle_pixels`
  and `frame_words` per frame in the stream so the FPGA's own view is visible, and check whether
  `cap_on` is being cleared early.
- 2.0–2.6 fps is the ceiling at 1 Mbaud with this compression. Frame differencing against a
  reference frame held in SDRAM is the obvious next gain — a calculator UI changes very little
  between frames — and would plausibly be worth an order of magnitude.

## 2026-08-03 (part 2) — WHOLE FRAME CAPTURED: 320x240 of the Prime's screen

**Status: `make frame-hw` → `PASS: frame captured and decoded, 240 lines of 320 pixels, 130 runt
edges rejected in hardware`.** A complete frame of the calculator's display, captured into SDRAM
and decoded into an image. New: `src/common/dotclk_sampler.v`,
`src/targets/frame_capture/`, `sim/targets/frame_capture/`, `python/tools/frame_capture.py`,
`make frame-hw`.

The decoded image is plainly the Prime's home screen: 613 distinct colours, 74% white background,
**row 0 a uniform `25 62 a8`** — the blue title bar — and rows alternating between 1 distinct
colour (blank) and 20–48 (text glyphs). 88.7% of pixels are greyscale, the rest blues.

### The bandwidth arithmetic chose the architecture, and chose what NOT to build

The obvious next move after the SDRAM worked was burst mode. The numbers said otherwise:

| Strategy | Rate | vs ~10.8 MW/s available |
|---|---|---|
| oversampled 108 MHz, 1 sample/word | 108 MW/s | impossible |
| oversampled 108 MHz, 2 samples/word | 54 MW/s | impossible |
| synchronous on DOTCLK, 1 sample/word | 13.29 MW/s | too fast |
| **synchronous on DOTCLK, 2 samples/word** | **6.64 MW/s** | **fits, 63% utilisation** |

So the answer was not a faster controller but cheaper sampling. Bursts would have been optimising
something that was never the bottleneck. Synchronous capture also cuts a frame from 11 MB to
688 KB — the 8 MB die holds eleven — and eliminates the runt-edge problem at source instead of
filtering it host-side.

`src/common/dotclk_sampler.v` samples once per DOTCLK on the rising edge, rejecting edges closer
than 4 cycles. On real hardware it rejected **130 runts** out of ~352,499 edges, consistent with
the 2-in-8064 rate measured during Phase 1 — and every one of them would have shifted a pixel
triplet and corrupted the rest of a line.

### Two bugs, both off-by-one, both found in simulation

1. **Auto-precharge on the wrong bit** (in `sdram_ctrl`, found earlier by the SDRAM model):
   `{2'b00, 1'b1, a_col}` puts A10's flag on A8, which on a 256-column part is inside the column
   field.
2. **Payload decode read one cycle early.** `do_read` is a registered pulse, so by the cycle it
   is high, `arg_sr` has already absorbed the last payload byte — every field shifts one position.
   It surfaced as `reply_count = 0`. `la_capture` avoided this by decoding from `rx_data` in the
   same cycle; here a 6-byte payload lands wholly in the shift register first.

### Structure

Capture is armed by the host and starts on the **next VSYNC falling edge**, so a capture is
frame-aligned by construction rather than by the host guessing. An 8-entry FIFO sits between the
sampler and the controller to absorb refresh stalls; overrun is reported, never silently
tolerated. It has not fired.

The testbench uses **Phase 1's `video_timing_gen` as its stimulus** — an independent
implementation of the protocol from anything in the capture path, so agreement is evidence rather
than tautology.

### Numbers

- Gowin signoff: 3463 paths, 0 setup / 0 hold. 759 logic (4%), 21/66 package I/O.
- All 55 SDRAM ports on internal pads, zero package pins — `frame_capture` uses exactly the same
  21 package pins as `la_capture`.
- 180,000 words = 703 KB drained in 8.7 s at 1 Mbaud.
- 360,000 samples → 240 DE runs, **every one exactly 320 pixels**.

### Open

- Drain is 8.7 s per frame, entirely UART-bound. Storing only active-DE samples would cut it to
  ~2.6 s; a faster link would do better still.
- Only one frame per arm. The die holds eleven, so multi-frame capture (motion, or averaging) is
  a parameter change plus host support.
- `la_capture` is still the right tool for protocol questions — oversampling shows edge placement
  and glitches that synchronous capture cannot. The two are complementary, not successive.

## 2026-08-03 — SDRAM WORKING: 8 MB written and verified on hardware

**Status: `make sdram-hw` → `PASS: SDRAM self-test, 2,097,152 words (8 MB) written and verified,
0 errors`, 5/5 consecutive runs, 0.52 s per full pass (30.7 MB/s including read-back). All five
simulations and all three bitstreams still pass.**

New: `sim/models/sdram_sim.v`, `src/common/sdram_ctrl.v`, `src/targets/sdram_selftest/`,
`sim/targets/{sdram_ctrl,sdram_selftest}/`, `python/tools/sdram_selftest.py`, `make sdram-hw`.

### The clock phase worked first time

`docs/sdram.md` flagged the `O_sdram_clk` phase offset as the most likely cause of "simulates
perfectly, reads garbage from silicon". Driving the die on `~clk` — half a cycle for every
registered output to settle before the die samples it — was right on the first attempt. Recording
that because the prediction was reasonable and simply did not come true; the risk was real, the
mitigation happened to be sufficient.

### The strict model earned its place immediately

Gowin ships no SDRAM simulation model ("please contact Micron Technology"), so
`sim/models/sdram_sim.v` had to be written anyway. It was built to *check* the protocol rather
than merely respond to it, and it caught a real bug on its very first run:

**Auto-precharge was on the wrong bit.** `{2'b00, 1'b1, a_col}` puts the flag on A8, which on a
256-column part is inside the column field. A10 is the top bit of the 11-bit address. The bank
therefore never closed, and the model said so precisely — `ACTIVATE on a bank that is already
active` — instead of the silent data corruption a real die would have produced.

Four mutations confirm the model discriminates, each with a diagnostic naming the actual fault:

| Mutation | Caught as |
|---|---|
| drop auto-precharge (A10 low) | `ACTIVATE on a bank that is already active` |
| never refresh in steady state | `refresh interval exceeded -- no AUTO REFRESH within tREFI` |
| issue READ/WRITE one cycle early | `READ/WRITE violates tRCD` |
| sample read data one cycle early | readback returns `0xzzzzzzzz` |

### A handshake race the unit test could not have found

The integration testbench deadlocked at word 22. Cause: `ready` was **registered**, so a requester
sees it a cycle late — and if a refresh falls due in that gap the controller takes the refresh
branch and the one-cycle `req` pulse is silently dropped. A dropped write skips a word; a dropped
read hangs forever waiting for `rvalid`.

`ready` is now combinational and means *"a request presented on this cycle will be accepted"*, and
the requester holds `req` until it observes `req && ready`. That is the only unambiguous transfer
point.

Worth noting how close this came to escaping: the unit-level testbench has the same latent race
and **passes either way**, because ~400 accesses rarely collide with a 15 µs refresh. On hardware,
with 4.2 million accesses per run, it would have been certain — and would have presented as "the
SDRAM hangs sometimes".

### Numbers

- Gowin signoff: 2537 paths, 0 setup / 0 hold violations.
- Resources: 602/20736 logic (3%), 447 registers (3%), **9/66 package I/O**.
- **All 55 SDRAM ports bonded to internal `p` pads; zero on package pins** — confirmed from the
  placed design, exactly as `docs/sdram.md` predicted.
- Measured 30.7 MB/s for a write pass plus a read-back pass over the whole 8 MB. Against the
  Prime's 8.69 MB/s that is comfortable, and it is a single-word controller with no bursts.

### Open

- **Single-word accesses only.** Every access pays a row activation: ~10 cycles per word. Burst
  mode and an open-row policy are the obvious next gains, and should be measured against this
  working baseline rather than assumed.
- The address map is `{bank, row, col}`. `{row, bank, col}` would let consecutive pages land in
  different banks so the next row could be activated while the current one still streams — worth
  doing only if burst mode needs the bandwidth.
- Timing constants are conservative standard SDR values, not part-specific; the data sheet defers
  its AC table to IPUG279, which is not installed. First place to look if throughput ever matters.
- Not yet wired to anything. Phase 2 (whole-frame capture) and Phase 4 (frame buffer) are the
  consumers.

## 2026-08-02 (part 8) — component order resolved: R, G, B (confirmed twice). Protocol spec complete.

**Status: the HP Prime's LCD protocol is fully specified.** A red screen captured as
**320 px of `ff 00 00` on every line** — the first byte of each triplet is RED, so the component
order is **R, G, B**.

That is unambiguous because the triplet phase had already been pinned independently, from
greyscale captures: 960 DOTCLKs per DE run dividing to exactly 320.00 pixels at sampling offset 0.
With the phase fixed, the first byte after DE rises is the first component, and a saturated red
screen puts 0xff there.

**Confirmed a second time with a green screen: `00 ff 00` on all 320 px of all three lines.**
Two independent single-colour captures, each isolating a different component:

| Screen | Captured pixel | Implies |
|---|---|---|
| red | `ff 00 00` | component 0 = **R** |
| green | `00 ff 00` | component 1 = **G** |
| — | — | component 2 = **B**, by elimination over a 3-component pixel |

A blue capture would be redundant. Both PPM outputs round-trip: 320x3, 960 px, every pixel exactly
(255,0,0) and (0,255,0) respectively — so the decoder, the triplet grouping and the PPM writer are
all confirmed end to end against known ground truth.

Incidentally the green capture rejected **zero** runt DOTCLK edges where every previous capture
rejected exactly one. That is consistent with the diagnosis — metastability is probabilistic, not
a fixed defect — and is a small independent check that the runt filter is not simply discarding a
real edge every time.

### Complete measured protocol

    320 x 240, serial RGB, 3 DOTCLKs per pixel, component order R G B
    DOTCLK   13.289 MHz, 75.25 ns, ~53% duty; data changes on the FALLING edge,
             latch on the RISING edge
    line     102.435 us (9.762 kHz) = 1361 DOTCLKs: 960 active + 401 blanking
    HSYNC    active low, ~1 DOTCLK wide
    DE       active high, 72.25 us
    VSYNC    active low, 37.7 Hz
    blanking data bus driven to 0x00

### The tool called a correct capture a failure

`decode_prime.py` reported `FAIL: no line decoded cleanly` on the red screen — 320 errors per
line — while printing the perfectly decoded `ff 00 00`. The pass criterion required
`R == G == B` on every pixel.

That was over-fitting to the sample data. Every capture up to that point happened to be of a
greyscale screen, so "greyscale" got quietly promoted from *a property of what I had measured* to
*the definition of correct*. The first genuinely coloured capture — exactly the one the check
existed to enable — was then rejected by it.

Fixed: correctness is now `960 DOTCLKs -> 320 pixels` and nothing else. The mixed-component count
is still reported, because on **known-greyscale** content a nonzero value does indicate a wrong
sampling point or triplet phase, but it can never be a pass criterion. Both captures now pass and
the output labels each line `[greyscale]` or `[N coloured px]`.

Worth remembering as a class of bug: an assertion derived from observed data rather than from the
specification will reject the first input that differs from the sample — and it does so most
confidently at exactly the moment the new input is the interesting one.

### Fixtures

`captures/` is gitignored (regenerable), but `prime_red.json` (uniform red) and
`prime_live.json` (greyscale home screen) are a useful pair to keep locally: one exercises the
coloured path, one the greyscale path, and they caught this bug between them.

### Open

- Capture depth is still 2.9 lines. The protocol is now fully known, so the remaining blocker for
  Phase 2 (render a frame) is purely the **SDRAM controller** — the same piece Phase 4's frame
  buffer needs. Nothing else about the Prime's side is unknown.
- The one runt DOTCLK edge per capture is worked around host-side; synchronous capture would
  remove it at the source and is the same RTL change that enables full-frame capture.

## 2026-08-02 (part 7) — FIRST REAL CAPTURE: the Prime's LCD bus is decoded

**Status: probes connected, all 12 channels live, and the interface is fully characterised from
real silicon. `python3 python/tools/decode_prime.py --live` → `PASS: decoded 3/3 line(s) to 320
pixels with consistent components, 0 errors`.** Bitstream is now in onboard flash, so the board
self-configures on power-up.

### Measured interface specification

Every figure below is from a capture, not a datasheet or an inference:

| Property | Measured |
|---|---|
| DOTCLK | **13.289 MHz**, period 75.25 ns, ~53 % duty |
| Clocks per pixel | **3** — 960 DOTCLKs per DE run ÷ 320 = **exactly 320.00 pixels** |
| Line period | **102.435 µs** (9.762 kHz), **1361 DOTCLKs**: 960 active + 401 blanking |
| HSYNC | active low, **8 samples = 74 ns ≈ 1 DOTCLK** wide |
| DE | active high, **72.25 µs** |
| VSYNC | active low, 37.7 Hz — static within a 303 µs window, as predicted |
| Data timing | changes 0–1 samples after the DOTCLK **falling** edge; **latch on the rising edge** |
| Blanking | data bus driven to **0x00** (only 4 distinct values outside DE across 9358 samples) |
| Content | greyscale in this capture: **R = G = B for every one of 320 px** on every clean line |

The 3-clocks-per-pixel result confirms the ILI9322-family serial-RGB hypothesis
`docs/architecture.md` has carried since the start. 960/320 came out to 320.00, not 319.6 — the
kind of number that needs no interpretation.

### Two decoding traps, both found by measurement rather than reasoning

1. **Latching midway between DOTCLK rising edges is wrong.** It is the obvious choice and it lands
   almost exactly on the falling edge at 53 % duty — precisely where the data changes. Sweeping
   the sampling offset 0–7 samples against "how many pixels come out with R≠G≠B" gave 0 mixed
   pixels at offsets 0–3 and tens at 4+. The failure mode is nasty: solid areas decode perfectly
   and only pixels at colour boundaries corrupt, which reads as anti-aliasing rather than as a
   bug. `SAMPLE_OFFSET = 0` — latch on the rising edge itself.

2. **One spurious DOTCLK edge per capture corrupted a whole line.** Reproducibly, one line per
   capture came out with 961 DOTCLKs instead of 960, and since pixels are triplets, every boundary
   after it shifted by one byte. Cause: oversampling an asynchronous 13.29 MHz clock only 8.1×
   means the 2-FF synchroniser occasionally resolves a metastable edge into a runt — 2 in 8064
   half-periods measured ≤ 1 sample wide. `decode_prime.py` now rejects rising edges arriving less
   than 4 samples apart, which is physically impossible for this clock. 3/3 lines clean afterwards.
   **The real fix is synchronous capture** (sampling ON DOTCLK), which is also what full-frame
   capture needs.

### What a decoded line looks like

Line 0 of a live capture, 320 px in 30 runs — the Prime's home screen:

    52 px  ff ff ff      white margin
   217 px  e1 e1 e1      grey field
     ...   ec/44/1e/ca/48/0e/08/b0 ...   glyph pixels on white

### New tooling

- `python/tools/decode_prime.py` — decodes a capture (saved JSON or live) into pixels, reports
  per-line DOTCLK and pixel counts, writes a dependency-free PPM, PASS/FAIL contract.
- `python/tools/la_capture.py --probe-check` — per-channel transitions, frequency, duty and
  narrowest pulse. This is what confirmed the wiring on first connection.

### Open

- **Component order (R,G,B vs B,G,R) is still undetermined**, because everything captured so far
  is greyscale — R=G=B for every pixel, which cannot distinguish orderings. Resolving it needs a
  screen with known, saturated colour on it. Concrete next step: put something strongly red on the
  Prime's display and re-capture.
- Capture depth is 2.9 lines. Enough for protocol work, not for an image. Full frames need the
  SDRAM controller, which is also what Phase 4's frame buffer needs.
- The one runt edge per capture is worked around host-side, not eliminated. Synchronous capture
  would remove it at the source.
- The WS2812 RGB LED lights because pin 79 is probe channel D4 — expected, cosmetic, does not load
  the signal (its DIN is high-Z CMOS at 5 V). Documented in `la_capture.cst`.

## 2026-08-02 (part 6) — Phase 3/4 panel analysed: no adapter needed, but no passthrough either

**Status: analysis only, no code change. Full write-up in `docs/panel_afy320240a0.md`; phase
roadmap in `docs/architecture.md` updated.** Panel is an Orient Display
**AFY320240A0-3.5INTH-C2** (`docs/AFY320240A0-3.5INTH-C2-spec.pdf`), 3.5″, **320×240 — an exact
resolution match for the HP Prime**, ST7272A driver, parallel RGB 24-bit, 3.3 V logic.

### The adapter question: no adapter needed for video

The panel's 40-pin 0.5 mm FPC matches the Tang Nano's `FPC-40-0.5mm` on **38 of 40 pins**, checked
pin-by-pin against the schematic's DISPLAY sheet. Power, all 24 colour lines, DOTCLK, HSYNC,
VSYNC, DE, DISP and the backlight all line up. The two that differ are both benign:

- **Panel pin 36 (SDA) is tied to GND by the board** and **pin 35 (SCL) is NC.** Harmless, because
  the panel specifies pin 3 (CS) as *"Ground"* and the board does exactly that — and per the
  datasheet, *"command loading … is completed at the next rising edge of CS"*. With CS permanently
  low no serial command can ever latch, so the SPI is disabled by design and the panel runs on
  default registers. Grounded SDA cannot corrupt anything and the panel can never drive it.

The board wires **RGB565**: R0–R2, G0–G1 and B0–B2 are grounded on the PCB. That is a property of
the board, so full 24-bit colour is unreachable by *any* adapter, not just by omitting one.

An adapter would only buy three optional things: control of DISP (see below), access to SCL/SDA to
change default registers, and the capacitive touch panel — which is on a *separate* 6-pin FFC
(I²C, ST1633I at 0x70) that the 40-pin connector does not carry at all. The board's pins 37–40 are
wired for *resistive* touch, which this panel does not have.

### The real finding: the Prime's timing is illegal for this panel

| | HP Prime (measured) | Panel (datasheet) |
|---|---|---|
| DOTCLK | 13.1 MHz | 5 / **6** / 8 MHz |
| Pixel rate | 4.37 MHz (if 3 clk/px) | 5–8 MHz |
| Line period | **104.1 µs** | 55 / **60** / 65 µs |
| Frame rate | **37.7 Hz** | ≈58–68 Hz |
| Resolution | 320×240 | 320×240 ✅ |

Every temporal figure is out of range; only the resolution matches. **Phase 4 cannot be a
wire-through** — it must capture a frame, buffer it, and re-emit on independently generated
panel-legal timing. That is exactly the "clock-domain crossing / rate-matching" risk
`architecture.md` always named for Phase 4, now measured instead of anticipated.

Output recipe derived from the timing table (back porches include the sync pulse width — the only
reading under which the parts sum to the quoted totals):

    Thbp 43 + Thdisp 320 + Thfp 8  = Th 371 DCLK   (typ 371 ✓)
    Tvbp 12 + Tvdisp 240 + Tvfp 8  = Tv 260 lines  (typ 260 ✓)
    at 6 MHz: line 61.8 us, frame 16.08 ms = 62.2 Hz

Because the SPI is unreachable, the datasheet's *"necessary to keep Tvbp=12 and Thbp=43 in sync
mode"* is a hard constraint, not a suggestion. DE mode avoids it entirely and is the lower-risk
choice; the board wires all three of HSYNC/VSYNC/DE so SYNC-DE mode is available.

### SDRAM is the next real building block, ahead of Phase 3 RTL

Two independent requirements converge on it:

- Phase 2 needs whole frames: 2.86 M samples at 108 MHz vs a 32768-sample BSRAM buffer.
- Phase 4 needs a frame buffer: 320×240 RGB565 = **1.23 Mbit** vs **828 Kbit** of BSRAM, half of
  which `la_capture` already uses.

The board's 64 Mbit SIP SDRAM answers both. Fallback if it proves expensive: an 8 bpp or paletted
frame buffer is 614 Kbit and does fit BSRAM.

### Open items on the panel

- **DISP (pin 31) is hard-tied to +3V3 by the board.** The power-on sequence wants `T1 ≥ 10 ms`
  between the internal GRB reset and DISP going high; tied to the rail it rises *with* VDD, so the
  requirement is very likely violated. Commodity boards do this routinely and it usually works —
  but if the panel fails to initialise, this is the first suspect, and the fix needs a cut trace
  or an interposer plus an FPGA pin. **Pin 52 is the one spare** and would serve.
- **`T2 ≥ 250 ms` from display signal to backlight on** — the FPGA owns `LCD_BL` (pin 49), so
  Phase 3 should hold the backlight off for 250 ms after the timing generator starts rather than
  enabling it at reset. Free to implement, easy to forget.
- **FPC contact orientation** — both are 40-pin 0.5 mm, but the contact side needs eyes on the
  hardware. If they disagree the fix is a flipped FFC extension, not an adapter board.
- **Backlight current** — panel wants 19.2 V at 40 mA, absolute max 50 mA. The board's boost
  driver (U6, R31 = 5.6 Ω sense) is in the right region but was designed for Sipeed's own 4.3″
  panel. Measure before running continuously; the datasheet is explicit that over-driving
  shortens LED life.

## 2026-08-02 (part 5) — Prime flex identified from scope data; probe pins re-mapped around the LCD connector

**Status: `la_capture` re-pinned, rebuilt, reflashed and re-verified on hardware
(`make capture-hw` → PASS, and the VSYNC-edge/wrap case → PASS). The twelve probe channels now
use ZERO of the RGB LCD connector's pins, so Phase 3/4 can still drive a panel. No RTL, testbench
or host-tool change — only `la_capture.cst`, a new `options.tcl`, and docs.**

### The scope survey identifies the interface

`docs/HP Prime LCD Pinout.xlsx` (45-pin flex). The arithmetic closes, which is what makes the
identification trustworthy rather than a guess:

| Flex pin | Measured | Signal |
|---|---|---|
| 7 | 9.8 kHz bursts, 24.7 ms on / 1.96 ms off | DE |
| 8 | 37.7 Hz | VSYNC |
| 9 | 9.61 kHz | HSYNC |
| 10 | 13.1 MHz | DOTCLK |
| 11–18 | logic | D0–D7 |

- Frame 26.53 ms, line 104.1 µs → **254.9 lines/frame**.
- Pin 7's *envelope* is the vertical structure: 24.7 ms = 237 active lines, 1.96 ms = 18.8
  blanking lines, total 256.2 — agrees with 254.9 within scope precision. Only DE has that shape.
- ~240 active of 255 total is a **320×240 panel**, which is the Prime's display.
- 1363 DOTCLKs per line. At 3 clocks/pixel that is 960 active + 403 blanking; at 4 clocks/pixel
  1280 + 83. Both plausible — deliberately not guessed, since resolving it is what the capture is
  for.

Twelve consecutive flex pins (7–18) for twelve channels, which is a clean fit to the existing
front end.

### The probe pin map was incompatible with Phase 3/4 — caught before anything was soldered

The original `la_capture` pin map predated the schematic analysis and put **nine of twelve probes
on RGB LCD connector pins** (77, 25, 26, 48, 27–31). It would have worked perfectly for Phase 1
and made Phase 3 impossible. The user caught it by asking whether re-mapping would cost the LCD
connector — the answer was that the *existing* map already had.

The DISPLAY sheet shows the connector permanently reserves twenty pins (25–42, 48, 77) plus 49
and 15–18. After also removing the BL616 pins and the LEDs, the 2×20 headers have exactly
**thirteen** pins left for twelve probes.

### Five of those thirteen are dedicated SSPI configuration pins

`gw_sh` refused them outright:

```
ERROR (PR2017) 'probe[9]' cannot be placed according to constraint,
               for the location is a dedicated pin (SSPI)
```

Without `set_option -use_sspi_as_gpio 1` only **eight** usable pins remain — not enough. So
Phase 1's twelve channels and Phase 4's LCD output can only coexist by reclaiming the SSPI pins.
Added `src/targets/la_capture/options.tcl` and a generic hook in `gowin_build.sh` that sources
`src/targets/<target>/options.tcl` when present; deliberately per-target rather than global,
since repurposing configuration pins is not something to switch on for every build. Safe here:
configuration is over JTAG and user flash is on MSPI (59–62), neither of which this touches.

### Final map (full table with caveats in `boards/tangnano20k/pinout.md`)

    flex   7   8   9  10  11  12  13  14  15  16  17  18
           DE  VS  HS  CK  D0  D1  D2  D3  D4  D5  D6  D7
    FPGA   51  53  71  80  72  73  74  85  79  56  54  55

Confirmed from the placed design: all twelve at the constrained pins, all Vccio 3.3, DOTCLK on
`GCLKT_0`, and **none of the 21 LCD-connector pins claimed**.

Three choices worth not re-litigating: DOTCLK on 80 because it is `GCLKT_0` (synchronous capture,
the only way a full frame fits in memory, needs a real global clock buffer); VSYNC on 53 because
it is the one pin with a 2.2 kΩ pull-up and a corrupted 37.7 Hz frame sync is obvious where a
corrupted data bit is silent; pin 51 over the spare 52 because 52 carries the second DDC pull-up.

### Also corrected

`pinout.md`'s Phase 3 table was carrying numbers from a Sipeed 480×272 example with a "re-verify
before relying on this" caveat. Now verified against the schematic and extended: the connector is
wired **RGB565** (R2..R0, G1..G0 and B2..B0 are tied to GND at the connector), and `LCD_INT0..3`
share pins 15–18 with four of the six LEDs.

### Open / next

- ⚠️ **Blocker for real probing: the Prime's logic level on flex pins 7–18 is unmeasured.** The
  survey records amplitudes for pins 27–29 and the 32–42 group but only frequencies for 7–18.
  These inputs are 3.3 V LVCMOS (V_IH ≈ 2.0 V); 1.8 V will not register. Measure flex pin 10
  (DOTCLK, continuously toggling) before connecting.
- ☠️ Flex pins 32–42 carry 16.88 V, −8.3 V, −3.3 V and 15.4 Vpp at 26.3 kHz — the TFT gate-driver
  region. Also lethal: flex 3/4 (5.5 V), 25 and 31 (5 V).
- Capture depth against real timing: 32768 samples at 108 MHz is 303 µs = **2.9 lines**. Enough to
  settle clocks-per-pixel and porch structure; a full frame is 2.86 M samples. Even synchronous
  capture on DOTCLK is 347,480 samples per frame, 10× the buffer — full-frame capture for Phase 2
  means the board's 64 Mbit SDRAM.
- Flex pins 27/28/29 (three isolated 3.3 V logic lines) look like the controller's SPI config
  interface. Capturing them at power-on would give the ILI9322's actual register settings rather
  than inferring them, which would de-risk Phase 3.
- Physical connection will be a **soldered pigtail to the flex** — hence getting the pin map right
  before wiring rather than after.

## 2026-08-02 (part 4) — PHASE 1: logic analyser capturing, triggering and draining on hardware

**Status: Phase 1 RTL complete and verified on the board. `make capture-hw` →
`PASS: la_capture mock capture, 24577 samples verified (DOTCLK period, HSYNC period, DE width,
RGB pattern), 0 errors`. All three simulations, both build paths, both bitstreams, and
proto-phase-1's own hardware self-test still pass. New target `la_capture`: 12 channels at
108 MHz into 32768 samples of BSRAM, mask/value trigger with selectable EDGE or LEVEL semantics,
pre-trigger history, and a windowed drain over the same 1 Mbaud BL616 link.**

Also merged proto-phase-1 to `main` (`96c1d35`) at the start of this session and re-verified it on
hardware: `make selftest-hw` 5/5, and a throwaway check confirmed `187cc10`'s CMD_RESYNC fix on
real silicon for the first time (mid-burst resync at 108 bytes in restarts the REAL counter at
0x00 — previously only simulated).

### What was built

| File | Role |
|---|---|
| `src/common/pll_27_108.v` | `rPLL` wrapper, 27 → 108 MHz |
| `sim/models/rPLL.v` | behavioural model of the Gowin primitive, sim-only, measures its input rather than parsing `FCLKIN` |
| `src/common/sync2.v` | N-bit 2-FF synchroniser |
| `src/common/video_timing_gen.v` | synthetic serial-RGB source (MOCK), R=x G=y B=x^y |
| `src/common/capture_engine.v` | circular BSRAM capture, trigger, pre/post-trigger, read port |
| `src/targets/la_capture/` | top level, `.cst`, `.sdc` |
| `sim/targets/la_capture/` | top-level testbench, 6 checks |
| `python/tools/la_capture.py` | host driver: arm, trigger, chunked drain, pattern verify, VCD out |

**108 MHz was chosen for two reasons that both had to hold:** `27 × 4` exactly, and
`108 / 1 = DIV 108` exactly for 1 Mbaud. That keeps the entire design in one clock domain — the
probe pins are the only CDC — and preserves the zero-division-error property that made 1 Mbaud
work at 27 MHz. Measured on the wire in simulation: 999,920 baud.

### Four bugs the process caught that the tests as first written did not

1. **Dead trigger logic, found by mutation testing.** Deleting the `!match_d` term from the
   trigger made *no test fail*. With `match_d` cleared at arm, "edge-sensitive" and
   "level-sensitive" are provably identical — the comment described behaviour the code did not
   have. Fixed by making the distinction real and selectable (`'E'`/`'L'`): LEVEL seeds `match_d`
   to 0, EDGE seeds it with the arm-time match so an already-true condition does not fire. This
   matters for the actual job — "capture the next VSYNC falling edge" returns the wrong frame if
   VSYNC happens to be low when the host arms. **Mutation-test a testbench before trusting it.**

2. **`BUILD PASS` on a design that violated timing.** After adding the windowed read, the clamp
   arithmetic became the critical path: Fmax 96.8 MHz against a 108 MHz constraint, 15 violated
   setup endpoints — and `gw_sh` exited 0, wrote a bitstream, and the hardware test *passed* at
   room temperature. Fixed twice over: the clamp is now pipelined across three cycles (nothing
   needs it for ~870 clocks), and `tools/build/gowin_build.sh` now parses
   `impl/pnr/project_tr_content.html` and fails the build on any setup/hold violation, a missing
   timing report, or an analysis covering 0 paths. Adding an `.sdc` (part 3) made the analysis
   *run*; this makes the result *matter*.

3. **No flow control on the drain.** Streaming the full 64 KB buffer at 1 Mbaud loses bytes: four
   consecutive full drains came up 263–1904 bytes short, non-deterministically, because nothing
   stops the FPGA transmitting while the host's driver buffer is full. Reading faster only narrows
   the window. Fixed with a windowed read command (`'G'` + start + count) so the host bounds what
   is in flight; it now fetches in 4096-sample chunks. Header gained a `reply_count` field
   (version 2, 10 bytes) so a clamped request cannot silently desync the stream.

4. **A truncated DE run, found only on hardware.** A capture starts at an arbitrary point in the
   frame, so the first DE run is partial by construction. The host checker flagged
   `DE run of 25 DOTCLKs, expected 96`. The testbench had the same latent flaw and passed by luck.
   Both now only check runs whose rising edge is inside the capture.

### Toolchain divergence, in three different directions in one session

`CLAUDE.md` already recorded that `WARN (EX3638)` (implicit net) is a Gowin *warning* and an
iverilog *hard error*. This session found the other two directions:

- `ERROR (EX2000)` — a reg driven from two `always` blocks — is a Gowin **hard error** that
  iverilog simulates without complaint.
- `ERROR: Multiple edge sensitive events found` — collapsing an async reset and a sync restart
  into `if (!rst_n || restart)` — is a **yosys** hard error that both Gowin and iverilog accepted.
  The first branch of an `always @(posedge clk or negedge rst_n)` block must test the asynchronous
  signal alone; OR-ing a synchronous condition in describes hardware that does not exist.

Passing any one toolchain is not evidence the RTL is well formed. `make build-oss` was documented
as an optional second opinion; on this evidence it is closer to mandatory. New RTL uses
`` `default_nettype none ``, which makes the implicit-net class an error in both tools.

### Board findings (from the schematic and datasheet PDFs now in `docs/`)

- **Pin 87 is `MODE1`** — the previous entry proposed it as the reset-button candidate "pending
  verification". Verified: it is the other half of pin 88's strap pair. This board has no safe
  external reset pin.
- **Pins 13, 75, 76, 86 wire to the BL616** as `SPI_SCLK/MISO/MOSI/DIR` — same hazard as pins
  69/70. Pins 71–74 (`HSPI_D0..D3`) reach only the headers despite the naming, and are safe.
- **The Gowin report's bank voltages are a tool default, not the board.** It lists pins 25–42 and
  79–86 as `LVCMOS18`; the POWER sheet shows every `VCCO` fed by a 3.3 V LDO and the datasheet
  legend marks all banks 3.3 V. Trusting the report would have ruled out the best contiguous probe
  run for no reason.
- Probe pins chosen, all 3.3 V, all header-accessible, none loaded by an onboard component: 77
  (DOTCLK, `GCLKT_1`), 25, 26, 48, 27–31, 71–73. Full table in `boards/tangnano20k/pinout.md`.

### `PR1014` — the earlier prediction was wrong

Part 3 predicted the `rPLL` would clear `WARN (PR1014)`. It does not. What it fixes is real: the
Global Clock Signals table now shows the 108 MHz `clk_s` on `PRIMARY` across all four quadrants,
where before the system clock reached logic through generic routing. But the warning persists,
now naming `clk_d` — the 27 MHz reference hop from pin 4 into the adjacent PLL, a net with one
load and no registers in its domain. Corrected in `pinout.md`, `CLAUDE.md` and the RTL comment.

### Numbers

- Gowin signoff: **4357 paths, 0 setup / 0 hold violations, Fmax 160.8 MHz** against 108 MHz.
- Resources: 847/20736 logic (5%), 493 registers (4%), **24/46 BSRAM** (53%, inferred as `SDPB`),
  21/66 I/O, 1/2 rPLL.
- Open-source path independently: `OSS BUILD PASS`, nextpnr estimates 114 MHz for `clk_s`.
- Capture: 32768 samples × 16 bits = 303 µs at 9.26 ns resolution.

### Open

- **The HP Prime's LCD interface voltage is unknown and blocks real probing.** These inputs are
  3.3 V LVCMOS (V_IH ≈ 2.0 V); if the Prime's bus is 1.8 V it will not register and a level
  shifter is needed. Measure before connecting anything. Nothing else in Phase 1 depends on this —
  the whole path is validated in MOCK.
- `oss_cad_build.sh` still passes nextpnr a 12 MHz target frequency rather than the real
  constraint, so its "PASS at 12.00 MHz" line means less than it looks. Gowin is the signoff path,
  but this should be wired to the `.sdc` value.
- Verilator lint noise (~88 warnings, mostly `PROCASSINIT`/`WIDTHTRUNC`/`ZERODLY` from the rPLL
  model) is high enough to hide a real warning. Unchanged from part 3, now worse.
- `leds[4]` on `bringup_selftest` (raw pin 88 level) still never read visually. `la_capture` does
  not use pin 88 at all.
- No pre-trigger *depth* control: `post_len` is settable, but the split between pre and post is
  implied by it rather than requested directly. Fine in practice.

## 2026-08-02 (part 3) — proto-phase-1 leftovers closed: timing constraints, deterministic resync

**Status: proto-phase-1 CLOSED. Both testbenches pass (`PASS: uart_tx/uart_rx loopback, 34 bytes`
and `PASS: bringup_selftest top-level, baud + LFSR cadence + command channel + mock/real resync`,
measured baud 1,000,028 on the wire). `make build` now runs real timing analysis: 351 paths,
0 setup / 0 hold violations, Fmax 205.4 MHz against a 27 MHz constraint. Branch
`fix/bringup-reset-and-uart-link` merged to `main`.**

Closes the three items the previous entry left open, except `leds[4]`.

### `bringup_selftest.sdc`: the build was reporting 0 violations because it checked 0 paths

`tools/build/gowin_build.sh` already auto-included `src/targets/<target>/<target>.sdc` when
present, so this needed no script change — the file simply did not exist. Without it `gw_sh`
emitted `WARN (TA1132) 'clk' was determined to be a clock but was not created` and ran **no**
static timing analysis whatsoever, while still reporting a clean build. This is the third
instance in this repo of the same failure shape (after pin 88/MODE0 and the missing top-level
testbench): **a tool reporting success because it was asked to check nothing.**

With the constraint: 351 paths, 0/0 violations, Fmax 205.4 MHz — 7.6x margin, and independently
corroborated by nextpnr-himbaechel's ~248 MHz estimate on the open-source path. Read the numbers
from `impl/pnr/project_tr_content.html`; `project.tr.html` is only a frameset.

The `.sdc` also carries three `set_false_path` exceptions with their justifications inline:
`uart_rx` (async input, already 2-FF synchronised inside `uart_rx.v`), `rst` (pin 88, a
diagnostic level wired straight to `leds[4]`, deliberately not in the reset path), and `leds[*]`
(human-visible, skew irrelevant).

### `WARN (PR1014)` is now explained rather than tolerated

`Generic routing resource will be used to clock signal 'clk_d'`. Pin 4's Function column in
`impl/pnr/project.rpt.txt` reads **`LPLL1_T_in`** — it is the left PLL's dedicated reference
input, not one of the five `GCLK_PIN`s. A design that bypasses the PLL therefore reaches the
PRIMARY global network through generic routing. Harmless at this size; the correct fix is to feed
pin 4 into an `rPLL`, which **Phase 1 needs anyway** for its oversampling clock — a PLL output
reaches a global buffer natively. Recorded in `pinout.md` and `CLAUDE.md` as a second instance of
the pin-88 "read the Function column before mapping a signal" lesson.

### `CMD_RESYNC` now restarts every data source

It previously reloaded the LFSR seed only, so REAL mode resumed from wherever `real_data_stub`
happened to be. Harmless in isolation — a full `BURST_LEN=256` burst wraps an 8-bit counter
exactly back to 0, so complete bursts looked identical — but a *partial* burst left the design in
a state no host command could recover. Phase 1 copies this module, and there the REAL source is a
capture buffer's read pointer, where "restart the source" has to mean all sources with no
exceptions to remember. Testbench check 5 covers REAL-mode framing and mid-burst resync, and was
confirmed **discriminating** by reverting the RTL fix and watching it fail with
`real_data_stub=0x41` — a test that has never been seen to fail is not yet known to test anything.

### Removed

`src/main.v` — a leftover Gowin GUI placeholder blinky, listed in no `files.txt` and built by
nothing. `HP_PRIME_LCD.gprj`'s FileList was dangling at it and now points at the real target
sources.

### Open

- `leds[4]` (raw pin 88 / MODE0 level) still not read visually. The strap explanation is confirmed
  from the vendor pin report and from the POR fix working, but the pin's level was never directly
  measured.
- Pin 87 (second button) never checked for a dual-purpose function; relevant only if a physical
  reset source is ever wanted.
- Verilator's informational lint pass emits ~35 warnings, all benign categories (`PROCASSINIT`
  from reset-value initialisers, `WIDTHTRUNC` on localparam division, unused testbench signals).
  Not blocking — `run_sim.sh` treats the pass as informational — but the noise floor is high
  enough to hide a real `LATCH` or width warning once Phase 1 lands. Worth cleaning before then.

## 2026-08-02 (later session, part 2) — Arduino removed; BL616 UART works at 1 Mbaud

**Status: proto-phase-1 COMPLETE. `make selftest-hw` → `PASS: hardware serial self-test, 256 bytes
verified, 0 errors` at 1,000,000 baud over the board's own USB connection, no external hardware.
5/5 consecutive runs, mock/real mux verified over the same link. The Arduino bridge has been
deleted from the repo.**

### The BL616 UART was never broken

Confirmed directly: the previous sessions' conclusion that macOS's `AppleUSBFTDI` made this path
unusable was a **ghost**. The FPGA was held in reset, so pins 69/70 were as silent as everything
else, and the silence was attributed to the host driver. An entire subsystem — Uno, resistor
divider, `SoftwareSerial`, two sketch rewrites, `arduino-cli` toolchain, a second self-test script,
~500 lines of docs — was built to route around a bug that was never on that side of the wire.

`uart_rx`→pin 70, `uart_tx`→pin 69 (checked the pin report's Function column first: both plain
GPIO, empty Function, unlike pin 88's `MODE0`). Worked on the first try.

### Baud raised to 1,000,000

`27 MHz / 1 MBaud = DIV 27` exactly — zero division error, vs. +0.16% at 115200. Simulation
measured 1000028 baud on the wire before anything was flashed. 26x the Arduino bridge's 38400,
which was purely a `SoftwareSerial` limitation. Matters for Phase 1, whose capture-buffer drain is
throughput-bound.

Done as two separately-verified steps — pins first at the known-good 38400, then baud — so each
change had exactly one suspect.

### BL616 interface selection (two real gotchas)

Both interfaces enumerate with identical VID:PID `0403:6010`, serial and location. The only
discriminator is the interface index appended to the macOS device name, so `serial_selftest.py`
sorts by device name and takes the last.

- **Interface A (`...170`) is JTAG and echoes what you write to it** — probing it returns your own
  bytes back, which reads as a working-but-corrupt link.
- **Interface B (`...171`) carries the BL616's own firmware log during JTAG programming**, in ASCII
  (` Write: 0x400000`). A self-test started immediately after `make flash-sram` reads log text and
  reports it as a data mismatch. `serial_selftest.py` now drains until the line is quiet first.

### Removed

`arduino/`, `boards/tangnano20k/arduino_bridge.md`, `python/tools/arduino_bridge_selftest.py`, and
the `selftest-bridge` Makefile target. All recoverable from git history (commit `a432019`) if a
bit-banged bridge is ever needed again — the `SoftwareSerial` throughput analysis in it is sound
and still applies to any AVR-based bridge.

### Added: `docs/verification.md`

A standing document on why testbench work is the primary instrument in FPGA development, not a
quality gate applied afterwards — grounded entirely in this project's measured costs. `CLAUDE.md`
now opens its workflow guidance with it and `docs/architecture.md` points at it first. The central
data point: proto-phase-1 is two UARTs, an LFSR and a mux; it had a *passing* module-level
testbench the entire time; the missing top-level testbench took ~20 minutes to write and found
three real bugs immediately, one of which (`tx_ready` used before declaration) meant the top module
was not legal Verilog and could never have been simulated at all.

### Open

- `leds[4]` (raw pin 88 level) still not read visually.
- Still no `.sdc` — see the previous entry; unchanged and now the main remaining risk for Phase 1.
- `CMD_RESYNC` still doesn't reset `real_data_stub` (harmless; wraps every 256 bytes).

## 2026-08-02 (later session) — proto-phase-1: hardware self-test PASSES; root cause was reset, not the bridge

**Status: RESOLVED and verified end-to-end. `make selftest-hw` →
`PASS: hardware serial self-test, 256 bytes verified, 0 errors`, 5/5 consecutive runs. `make sim`,
`make sim SIM_TARGET=bringup_selftest`, `make build`, `make flash-sram`, `make check-env` all
pass. The mock/real runtime mux was also verified over the wire.**

### Root cause: the design was held in reset the entire time

`rst` was mapped to **pin 88, which is the GW2AR-18C's `MODE0` configuration strap**, not a plain
GPIO — visible all along in the Gowin pin report (`impl/pnr/project.rpt.txt`, Function column for
`rst`). The board's strapping overrides the `.cst`'s `PULL_MODE=UP`, so `rst` read low, `rst_n`
stayed asserted, and every sequential block except one was frozen. `uart_tx` sat at its reset
value (idle high) and the FPGA never transmitted a single bit.

**Why three sessions of diagnosis missed it:** `heartbeat` is the one register in
`bringup_selftest_top.v` declared `always @(posedge clk)` with *no* reset term. It therefore keeps
counting while the rest of the design is in reset. Every "heartbeat LED confirms the bitstream is
alive" check in the sessions above was true *and* fully compatible with the design being dead.
The previous session's multimeter reading corroborated this and was misread at the time: pin 72
measured **3.4V**, but a pin actively streaming UART data would average ~1.6V (one start bit low,
~50% data ones, stop bit high). 3.4V was an undisturbed idle line — the FPGA saying it wasn't
transmitting.

Fix: an internal power-on reset (`por_cnt`, releases ~1.2ms after configuration). Pin 88 is no
longer in the reset path; `leds[4]` now exposes its raw level for visual confirmation.

**The BL616 investigation in the session below was very likely chasing a ghost.** Pins 69/70 would
have been equally silent for this same reason. Whether the `AppleUSBFTDI` claim is a real
additional obstacle is now untested — worth re-checking before anyone invests in that path again.

### Three further real bugs found once the link came up

1. **`tx_ready` was used before declaration** (line 55 vs 67), creating an implicit net. Gowin only
   *warned* (`WARN (EX3638)` — present in every build log and treated as cosmetic); iverilog
   rejects it outright, which is why this target had never had a top-level testbench. Declaration
   moved above first use.
2. **The LFSR advanced twice per transmitted byte.** `en(tx_ready && mode_mock)` — `tx_ready` is
   high for *two* cycles per byte, not one. The FPGA's stream could therefore never have matched
   `serial_selftest.py`'s reference model even with a perfect link. Now gated on
   `tx_fire = tx_ready && tx_valid`, a clean one-cycle-per-byte pulse (also used for `tx_count`
   and `real_data_stub`).
3. **Free-running TX made framing impossible.** `tx_valid <= tx_ready` streamed back-to-back
   forever with no inter-frame idle, so a receiver had no way to establish framing (a data bit's
   falling edge is indistinguishable from a start bit), and `serial_selftest.py`'s "first byte
   after resync == SEED" raced against bytes already in flight. Replaced with **burst-on-demand**:
   `CMD_RESYNC` reloads the seed and arms exactly `BURST_LEN` (256) bytes; the line is idle
   otherwise.

### Bridge throughput: the two links now run at different baud rates

With everything above fixed, the self-test got to **byte 115 of 256** and then read `0xe7` where it
expected `0xf3` — and `lfsr_next(0xf3) == 0xe7`, i.e. exactly one byte *dropped*, not corrupted.

`SoftwareSerial`'s RX ISR holds interrupts disabled for a whole byte time, which blocks the
hardware USART's `UDRE` interrupt and stalls outgoing TX. At 115200 on both sides the outbound
rate is therefore *strictly lower* than the inbound rate, and a sustained burst overruns the
64-byte buffer regardless of its size. Fixed by decoupling the two links:
- `USB_BAUD  = 115200` (hardware UART, Uno ↔ Mac) — matches `BAUD` in both Python scripts
- `FPGA_BAUD = 38400`  (bit-banged, Uno ↔ FPGA) — matches `BAUD` in `bringup_selftest_top.v`

This is a *bridge* limitation, not an FPGA one. If the BL616 path (or a real USB-serial adapter)
is ever adopted, both sides can go back up.

### New: `sim/targets/bringup_selftest/` — top-level testbench

The gap that let all of the above through: `bringup_uart_loopback` only tests `uart_tx` against
`uart_rx`. Nothing tested `bringup_selftest_top` itself. The new testbench checks the on-the-wire
bit time (recovering baud from the narrowest edge-to-edge interval — the shortest possible UART
pulse is exactly one bit), the LFSR-to-byte cadence 1:1, deterministic framing (byte 0 must be
SEED exactly), and the RX command channel. It caught bugs 2 and 3 directly.

Two testbench-authoring notes worth remembering: `micros()`-style sequential capture must be
armed **before** the command finishes going out (`uart_rx` asserts `rx_valid` mid-stop-bit and the
burst starts ~4 clocks later, while `send_byte` is still driving its own stop bit — hence the
`fork`/`join`), and the watchdog is counted in **clocks**, not a `#delay`, because the required
ceiling in ps overflows Verilog's default 32-bit unsized literal.

### Host tooling fixes

- `serial_selftest.py`'s `find_port()` fell back to `ports[0]`, which on macOS is reliably
  `/dev/cu.Bluetooth-Incoming-Port` — it opens fine and returns nothing, producing a confusing
  0-byte timeout. Now filters on the Arduino VIDs like `arduino_bridge_selftest.py` does.
- Opening the port asserts DTR and **auto-resets the Uno**; the bootloader then holds the line for
  ~1.5s and swallows anything sent during that window. Added a `--settle` wait (default 2.5s).
- `--count > BURST_LEN` now fails with an explicit message instead of a bare timeout.

### Not yet done / open questions

- `leds[4]` (raw pin 88 level) has not been read visually — the MODE0 strap explanation is
  confirmed from the vendor pin report and from the POR fix working, but the pin's actual level
  was never directly measured. Quick confirmation for whoever is next at the bench.
- `CMD_RESYNC` reloads the LFSR seed but does **not** reset `real_data_stub`, so REAL mode resumes
  from wherever the counter was. Harmless (it wraps every 256 bytes, so bursts look identical),
  but making resync reset both would make the reference implementation deterministic in both
  modes — worth doing when Phase 1 copies this pattern.
- The board's second button (pin 87) was never tested as a reset source. If a physical reset is
  wanted, verify pin 87 has no dual-purpose function before wiring it into the reset path.
- **There is no `.sdc`, so no timing analysis is actually running.** The two remaining `gw_sh`
  warnings say so: `WARN (TA1132) 'clk' was determined to be a clock but was not created` and
  `WARN (PR1014) Generic routing resource will be used to clock signal 'clk_d'` (i.e. `clk` is not
  on a global clock buffer). Both are harmless for a 27 MHz design this small — and the
  open-source path independently reported ~248 MHz Fmax — but this should be fixed before Phase 1
  adds BSRAM and a PLL, where unanalysed timing stops being safe.

## 2026-08-02 — proto-phase-1: BL616 UART dead end on macOS, Arduino bridge in progress (unresolved)

**Status: IN PROGRESS, not passing yet. Board connected all session. `make check-env`, `make
build`, `make build-oss`, `make flash-sram` all still work. Hardware UART self-test
(`make selftest-hw`) still fails — currently 0 bytes received through the newest bridge
configuration. Next action on resume: check whether `leds[3]` (the new sticky rx-indicator, see
below) lights up after sending a byte through the Arduino relay sketch — that question was
in-flight when this session paused.**

### Part 1: the BL616 onboard UART is unusable from macOS (dead end, not pursued further)

Ran the documented next step from the 2026-07-30 session: `make flash-sram` then
`make selftest-hw` against `bringup_selftest`. Flash succeeded and the bitstream was confirmed
alive (heartbeat LED), but the self-test timed out with 0 bytes.

Diagnosed extensively: both enumerated serial endpoints of the onboard debugger tested in both
directions, at multiple baud rates, with DTR/RTS explicitly controlled — all silent. Installed
`pyftdi` (`pip install --user --break-system-packages pyftdi`, plus `brew install libusb`) to
bypass the OS tty layer and talk to the FTDI-emulated interfaces directly: one interface returned
0 bytes, the other timed out entirely on a USB control transfer (macOS's built-in
`AppleUSBFTDI` kernel driver claims both interfaces exclusively; getting `pyftdi` to touch the
second one would require `sudo kextunload`, judged too invasive to do without asking first).

Pulled the official Sipeed KiCad schematic (`tang_nano_20k_schematic_v1.3.pdf`, readable directly
via the `Read` tool's PDF support) to settle it definitively: `USB_JTAG.kicad_sch` confirms chip
`U5` is genuinely a `BL616C-S0-Q2I-QFN40` (not FTDI silicon — it emulates an FTDI FT2232H USB
descriptor purely for driver compatibility, which is why `ioreg`/`system_profiler` reported FTDI
VID:PID `0403:6010`). `MAIN.kicad_sch` confirms `PIN69_SYS_TX`/`PIN70_SYS_RX` wire directly to
`BL616_UART_TX`/`BL616_UART_RX` with no jumper — i.e. **the RTL and `.cst` pin assignment were
correct all along; this is a host driver problem, not a design bug.** `boards/tangnano20k/
pinout.md` updated with a caveat pointing here instead of asserting the BL616 UART "just works."

### Part 2: Arduino Uno bridge — attempt 1 (bare 16u2 adapter via grounded RESET) — abandoned mid-diagnosis

Plan (drafted locally, then refined via an Ultraplan cloud session and teleported back — that
mechanism has no git remote/branch integration in this repo currently, the "teleport" just
re-delivers the plan text into the local conversation) called for grounding the Uno's `RESET`
pin to disable the ATmega328p, using the 16u2 chip as a bare USB-CDC-to-UART adapter on D0/D1, at
1,000,000 baud (matching the design), with a 1kΩ/2kΩ resistor divider stepping the Arduino's 5V
`D1` output down to ~3.33V before it reaches the FPGA's 3.3V-only `uart_rx` pin.

Built: `python/tools/arduino_bridge_selftest.py` (loopback self-test, PASS/FAIL contract),
`boards/tangnano20k/arduino_bridge.md` (now rewritten for attempt 2, see below), `Makefile`
`selftest-bridge` target + `PORT=` override on both hardware-test targets. Had to widen
`find_port()`'s VID filter from just `0x2341` to `(0x2341, 0x2a03)` — this specific Uno enumerates
under Arduino SA's `0x2a03`, not the older Arduino LLC `0x2341`.

**Phase A (Arduino-only, FPGA disconnected) passed:** `make selftest-bridge` →
`PASS: arduino bridge loopback, 256 bytes verified, 0 errors` at 1,000,000 baud — confirmed the
16u2 could drive/receive real data at the design's full baud rate at that point in time.

User caught before wiring to the FPGA that pins 69/70 (originally documented) are hard-wired
directly to the BL616 (see Part 1's schematic finding) — driving them externally would contend
with the BL616's own driver. Remapped `bringup_selftest`'s `uart_rx`/`uart_tx` to pins 71/72
instead (`bringup_selftest.cst`, RTL port comments, `pinout.md` table all updated to match).

Rebuild hit a real, now-fixed tooling bug: `gowin_build.sh`'s final `cp` failed with
`Permission denied` — `gw_sh` writes its `.fs` output read-only, and a plain `cp` can't overwrite
a read-only destination left over from a prior build of the same target. Fixed with `cp -f`
(comment left in place explaining why).

**Phase B (real FPGA, pins 71/72) failed: 0 bytes, both directions silent.** Systematic diagnosis
with the user, in order: heartbeat LED confirmed bitstream alive (rules out reflash/reset
problems) → `FORCE_REAL` command sent via the bridge, mode LED (`leds[1]`) didn't change (RX
direction not getting through) → common ground confirmed present → D1→pin71/D0→pin72 orientation
confirmed correct (no TX/RX swap) → multimeter at pin 71 read 0.5V instead of the expected
~3.33V idle-high (pin 72, the FPGA's own driven output, correctly read 3.4V, validating the
measurement technique) → resistor values confirmed correct (1k/2k) → theorized the 16u2 might
only actively drive TX while the host's virtual COM port is open; tested by holding the port open
during a fresh measurement — no change → **isolated further with a forced serial BREAK
toggle (idle-high → held-low → idle-high) while probing `D1` directly, out of circuit with
everything downstream disconnected — the user found literally no voltage response to any of it.**
Root cause of *that* was never determined (most likely theory: the `RESET`→`GND` jumper had come
loose while rewiring for the FPGA connection, letting the 328p resume control of the shared D0/D1
bus and contend with the 16u2 — consistent with Phase A having worked earlier in the exact same
nominal configuration) — **not confirmed, abandoned in favor of a different approach** rather
than root-caused further.

### Part 3: Arduino Uno bridge — attempt 2 (real sketch on the 328p via SoftwareSerial) — in progress

User's call: stop fighting the bare-16u2/grounded-RESET trick, disconnect that jumper, and run a
normal sketch on the 328p instead. Since the Uno's one hardware UART is already committed to the
USB link (via the 16u2, used normally now), the FPGA link moved to a `SoftwareSerial` pair on
spare pins D2 (RX, direct from FPGA pin 72)/D3 (TX, through the same 1k/2k divider, to FPGA pin
71) — RESET is *not* grounded in this approach.

Installed `arduino-cli` (`brew install arduino-cli`) + the AVR core
(`arduino-cli core install arduino:avr`) for headless compile/upload, matching this repo's
headless-tooling ethos. New sketch: `arduino/fpga_uart_bridge/fpga_uart_bridge.ino` — a plain
byte-for-byte relay between `Serial` (USB/Mac) and `fpgaSerial` (`SoftwareSerial(2,3)`, FPGA).
Compiled and uploaded successfully (`avrdude`, 3112 bytes, exit 0) — this also incidentally
confirmed the `RESET` jumper really was disconnected, since bootloader upload needs the normal
auto-reset sequence.

**Baud dropped to 115200 everywhere** (`SoftwareSerial` is bit-banged and can't reliably hit
1,000,000 baud on a 16MHz AVR — this is the documented fallback path from the original plan,
now actually needed): `bringup_selftest_top.v`'s `BAUD` localparam, `serial_selftest.py`'s and
`arduino_bridge_selftest.py`'s `BAUD` constants, and the sketch's `BAUD` constant all changed
together. Rebuilt and reflashed (`make build && make flash-sram`) — hit a transient
`unable to open ftdi device` on the first flash attempt right after the Arduino upload (JTAG
device briefly not enumerated, likely a USB re-enumeration blip from reprogramming the Arduino on
the same host); succeeded immediately on retry with no code changes.

`make selftest-hw PORT=<arduino-port>` against the new sketch-relay path: still 0 bytes. Heartbeat
LED reconfirmed alive. Sent `FORCE_REAL` again; user (reasonably) didn't have `leds[1]`'s
mode-snapshot semantics memorized, so added a new **sticky diagnostic LED** instead of continuing
to rely on it: `leds[3]` (pin 18) in `bringup_selftest_top.v` now latches on permanently the
instant the FPGA receives even one valid UART byte since reset (`rx_ever` register, set by
`rx_valid`, never cleared except by `rst_n`) — unlike `leds[1]`, it needs no timing/interpretation
to read. Rebuilt, reflashed. Sent a test byte through the new sketch relay. **Session paused
before checking whether `leds[3]` lit up — this is the next thing to check on resume.**

### Current wiring (as of session end)

Arduino Uno: `RESET` **not** grounded (running `fpga_uart_bridge.ino` normally). `D3` (softSerial
TX) → 1kΩ/2kΩ divider → FPGA pin 71 (`uart_rx`). `D2` (softSerial RX) ← direct wire ← FPGA pin 72
(`uart_tx`). Common GND confirmed present between boards. FPGA's own USB (JTAG/debugger) also
connected throughout. Both `bringup_selftest` (FPGA) and the sketch (Arduino) are running at
115200 baud. See `boards/tangnano20k/arduino_bridge.md` for the full current wiring
reference — it's been kept in sync with this approach, not the abandoned attempt 1.

### Not yet done / open questions for next session

- ❌ Hardware self-test still not passing. Immediate next step: check `leds[3]` after sending a
  byte via the Arduino relay (`python3 -c` snippet or `make selftest-hw`) — if it lights up, RX
  direction works and the remaining fault is TX (FPGA→Arduino→Mac); if it stays dark, RX is still
  broken and the fault is upstream of the FPGA (sketch, D3/divider, or pin 71 connection) —
  re-verify the D3 node voltage with a multimeter (expect ~3.3V, matching the earlier pin-71
  measurement methodology from attempt 1) as the next diagnostic if so.
- Root cause of attempt 1's D1-driving failure was never confirmed (theory: loose `RESET`
  jumper) — moot for now since attempt 2 doesn't use that trick, but worth remembering if a
  future bare-16u2 approach is ever retried.
- `gowin_build.sh`'s `cp -f` fix is real and should stay; not board/pin-remap-specific.
- Baud is now 115200 across the whole `bringup_selftest` design, not the original 1,000,000 —
  this is a permanent change (SoftwareSerial constraint), not reverted when/if the BL616 path or
  attempt-1-style bridge is ever revisited (those could go back to 1,000,000 if desired).

## 2026-07-30 — proto-phase-1: agentic dev environment bootstrap

**Status: fully working and verified end-to-end, both build paths. Board not connected this
session, so hardware flash + serial self-test are the one remaining manual step.**

Built:
- Repo scaffolding per `docs/architecture.md` (`src/{common,targets}`, `sim/targets`,
  `tools/{setup,sim,build}`, `python/tools`, `captures/`, `docs/`, `boards/tangnano20k/`).
- Fixed `HP_PRIME_LCD.gprj` device string bug (`GW2A-LV18QN88C8/I7` → `GW2AR-LV18QN88C8/I7`).
- `src/common/{lfsr8,uart_tx,uart_rx}.v` — reusable across all phases.
- `sim/targets/bringup_uart_loopback/` — first self-checking testbench.
- `src/targets/bringup_selftest/` — first synthesizable target, reference implementation of
  the mock/real runtime-mux convention.
- `tools/build/gowin_build.sh` — headless `gw_sh` wrapper (Gowin, primary/signoff path).
- `tools/build/oss_cad_build.sh` — yosys + nextpnr-himbaechel + apycula path (secondary).
- `tools/build/flash.sh`, `tools/sim/run_sim.sh`, `tools/setup/{install_tools,check_env}.sh`,
  root `Makefile`.
- `python/tools/serial_selftest.py` — hardware-loop self-test (not yet run against real
  hardware; board not connected this session).
- `CLAUDE.md`, `docs/architecture.md`, `boards/tangnano20k/pinout.md`, this file.
- Git repo initialized, `.gitignore` in place, initial commit made.

Verified this session (all commands actually run, not just planned):
- ✅ `make sim` — `PASS: uart_tx/uart_rx loopback, 34 bytes verified, 0 errors`, exit 0.
- ✅ `make build` (Gowin `gw_sh`, primary path) — `BUILD PASS`, bitstream produced and
  confirmed to be the actual fresh build (not a stale copy — see bug note below).
- ✅ `make build-oss` (yosys/nextpnr-himbaechel/apycula, secondary path) — `OSS BUILD PASS`,
  after fixing three real integration bugs (see below). nextpnr reports the design closes
  timing at 248 MHz max vs. a 12 MHz requirement — huge margin at this design's size.
- ✅ `tools/setup/check_env.sh` — all `PASS:`/`INFO:` as expected, including a live
  `gw_sh` headless launch check.

Bugs found and fixed during verification (all now encoded as comments/gotchas in
`tools/build/*.sh` and `CLAUDE.md` so they aren't rediscovered):
1. **`gowin_build.sh` silently copied a stale bitstream.** `gw_sh`'s default `impl/` output
   dir is CWD-relative; running it from inside `impl/` produced a nested `impl/impl/pnr/`, and
   the script's `ls impl/pnr/*.fs | head -1` glob picked up a leftover bitstream from the
   original placeholder-blinky build instead (confirmed via MD5 — byte-identical to the old
   file, not the new one). Fixed by running `gw_sh` from the repo root and checking a
   deterministic path (`impl/pnr/project.fs`) with an mtime-freshness guard.
2. **`oss_cad_build.sh` fed yosys a broken multi-file command.** `$SOURCES` (one file per line)
   was interpolated into a double-quoted `-p` script string, so yosys parsed each subsequent
   file path as its own invalid command. Fixed by joining with spaces before interpolation.
3. **`nextpnr-himbaechel`/`gowin_pack` clobbered the source `.cst`.** Both tools rewrite the
   constraints file they're given (with post-place-and-route site names, not pin numbers) —
   pointing them at `src/targets/bringup_selftest/bringup_selftest.cst` destroyed the
   human-authored pin constraints the vendor build also depends on. Caught immediately (the
   harness flagged the unexpected file change) and the original restored from what was written
   earlier in the same session. Fixed by copying the `.cst` into `build_oss/<target>/` first and
   only ever pointing the open-source tools at that throwaway copy.
4. Also needed, found via trial and error against the actual binaries: `nextpnr-himbaechel`
   requires the *full* Gowin part number as `--device` (short form defaults to an invalid speed
   grade) plus an undocumented `--vopt family=GW2A-18C`; `gowin_pack -d` needs `GW2A-18C` (no
   `R` — apycula has no separate R-variant database, it shares the base fabric db).

Not yet done:
- ❌ Hardware flash + `serial_selftest.py` — board not connected this session. Manual follow-up:
  connect the Tang Nano 20K, then `make flash-sram && make selftest-hw`.
- `oss-cad-suite` is installed at `~/.local/oss-cad-suite` but not added to the shell profile's
  PATH permanently (only exported ad hoc during verification) — add it yourself if you want
  `make build-oss` to work without manually exporting PATH first.

Next: once the board is connected and hardware self-test passes, start real Phase 1
(logic-analyzer RTL) — see `docs/architecture.md` for the roadmap.
