davidg5678/HP-Prime-IPS-LCD-Mod-FPGA/docs/HP Prime LCD Pinout.xlsx

Pin # | Signal | Notes
1 | GND
2 | GND
3 | 5.5V
4 | 5.5V
5 | GND
6 | GND
7 |  | Logic | 9.8khz bursts for 24.7 ms with 1.960ms gaps in between
8 |  | Logic | 37.7hz pulses
9 |  | Logic | 9.61 khz
10 |  | clock | 13.1Mhz
11 |  | Logic | 10khz
12 |  | Logic
13 |  | Logic
14 |  | Logic
15 |  | Logic
16 |  | Logic
17 |  | Logic
18 |  | Logic
19 |  | Noisy GND
20 |  | Noisy GND
21 |  | Noisy GND
22 | 3.3V
23 | 3.3V
24 | 2v
25 | 5v
26 | 3.3v
27 |  | Logic | 3.3v dc offset, but also 3.3vpp logic signals
28 |  | Logic | 3.3v logic signals
29 |  | Logic | 3.3v dc offset, but also 3.3vpp logic signals
30 |  | Logic | 0.5V dc offset, with 1vpp pulses
31 | 5v
32 |  | Logic | 26.3khz 3.3vpp
33 |  | Logic | 26.3khz -3.3vpp
34 | -3.3V
35 | 16.88v
36 | -8.3v
37 |  | Logic | 15.4vpp, 5.7v upper, -8.5v lower, 26.3khz
38 |  | Logic | 15.2vpp, 17v upper, 2.91v lower, 26.3khz
39 |  | Logic | 6.5vpp, 25.9khz
40 |  | Logic | 8.4vpp, 17.2v upper, 11.2v lower, 26khz
41 |  | logic | 6.5vpp, 25.9khz
42 |  | logic | 7.6vpp, 11.3v upper, 5.57v lower, 25.6khz
43 |  |  | -1v
44 | 4v
45 | GND
