davidg5678/HP-Prime-IPS-LCD-Mod-FPGA/sim/targets/bringup_selftest/tb_bringup_selftest.v

`timescale 1ps/1ps
//
// Top-level testbench for bringup_selftest_top. This is the test that was
// missing: bringup_uart_loopback only exercises uart_tx/uart_rx against each
// other, so nothing ever checked the *integration* -- the baud actually
// produced on the pin, the LFSR-to-byte cadence, or the command channel.
//
// Checks, in order:
//   1. uart_tx's on-the-wire bit time matches the design's BAUD localparam.
//   2. The LFSR advances exactly once per transmitted byte (a 2x advance makes
//      the FPGA stream disagree with serial_selftest.py's reference model).
//   3. The decoded byte stream matches that same reference model.
//   4. The RX command channel works: 0xAA reaches the design (rx_ever latches).
//   5. REAL mode streams its source from a defined start, and 0xAA restarts
//      that source too -- not just the LFSR.
//
module tb_bringup_selftest;
    localparam integer CLK_HZ  = 27_000_000;
    localparam integer BAUD    = 1_000_000; // must match bringup_selftest_top.v
    // The 64'd prefixes are LOAD-BEARING. An unsized Verilog integer literal is
    // 32 bits, and both numerators exceed 2^32 (5e11 and 1e12), so without them
    // the constant folding overflows and these evaluate to garbage. Icarus
    // happens to fold at wider precision and got the right answer anyway,
    // whereas a standard-conforming tool produces a bit time that hangs the
    // bit-banged UART -- surfacing only as a watchdog timeout. (Note: a comment
    // line must not BEGIN with the word verilator, or it is parsed as a pragma
    // and the build fails with BADVLTPRAGMA. Learned the direct way.)
    //
    // docs/verification.md warns about exactly this ("a 22 ms timeout expressed
    // in ps overflows it silently") -- and this file then did it two lines from
    // the watchdog the warning is about. The trailing comment on BIT_PS also
    // said 8680555 ps, which is the 115200-baud figure from before this link
    // moved to 1 Mbaud; at 1 Mbaud a bit is 1 us.
    localparam integer HALF_PS = 64'd500_000_000_000 / CLK_HZ;   // 18518 ps
    localparam integer BIT_PS  = 64'd1_000_000_000_000 / BAUD;   // 1_000_000 ps
    localparam [7:0]   SEED    = 8'h01;
    localparam [7:0]   CMD_RESYNC     = 8'hAA;
    localparam [7:0]   CMD_FORCE_REAL = 8'h52; // 'R'
    localparam integer NBYTES  = 64;
    localparam integer BURST_LEN = 256; // must match bringup_selftest_top.v

    reg clk = 0;
    always #(HALF_PS) clk = ~clk;

    reg        rx_line = 1'b1;
    wire       tx_line;
    wire [5:0] leds;

    bringup_selftest_top dut (
        .clk(clk), .rst(1'b1),
        .uart_rx(rx_line), .uart_tx(tx_line),
        .leds(leds)
    );

    integer errors = 0;

    // ---- reference model: mirrors lfsr_next() in python/tools/serial_selftest.py
    function [7:0] lfsr_next(input [7:0] v);
        reg fb;
        begin
            fb = v[7] ^ v[5] ^ v[4] ^ v[3];
            lfsr_next = {v[6:0], fb};
        end
    endfunction

    // ---- check 2 instrumentation: byte launches vs LFSR advances
    integer byte_launches = 0, lfsr_advances = 0;
    reg counting = 0;
    always @(posedge clk) if (counting) begin
        if (dut.tx_ready && dut.tx_valid) byte_launches <= byte_launches + 1;
        if (dut.u_lfsr.en && !dut.u_lfsr.load_seed) lfsr_advances <= lfsr_advances + 1;
    end

    // ---- check 5 instrumentation: what does real_data_stub hold immediately
    // after a resync? A hierarchical peek is the only way to ask this precisely.
    // do_resync is high for one cycle N; the RTL zeroes real_data_stub on the
    // N->N+1 edge, so sampling one cycle behind do_resync reads the post-resync
    // value. Without the fix this reads whatever the counter had reached
    // (~NBYTES); with it, exactly 0.
    reg       snoop_en  = 1'b0;
    reg       resync_d  = 1'b0;
    reg       resync_seen    = 1'b0;
    reg [7:0] real_at_resync = 8'hFF;
    always @(posedge clk) begin
        resync_d <= dut.do_resync;
        if (snoop_en && resync_d) begin
            real_at_resync <= dut.real_data_stub;
            resync_seen    <= 1'b1;
        end
    end

    // A burst is BURST_LEN bytes with no meaningful inter-byte gap; the line
    // going quiet for many bit times is how you know it has finished. Polling
    // for sustained idle is more robust than counting remaining bytes, which
    // would bake this testbench's framing assumptions in twice.
    task wait_burst_done;
        integer idle_bits;
        begin
            idle_bits = 0;
            while (idle_bits < 20) begin
                #(BIT_PS);
                if (tx_line === 1'b1) idle_bits = idle_bits + 1;
                else idle_bits = 0;
            end
        end
    endtask

    // ---- behavioural UART receiver at the *expected* baud
    task rx_byte(output [7:0] b);
        integer i;
        begin
            @(negedge tx_line);
            #(BIT_PS + BIT_PS / 2); // centre of bit 0
            for (i = 0; i < 8; i = i + 1) begin
                b[i] = tx_line;
                #(BIT_PS);
            end
        end
    endtask

    task send_byte(input [7:0] b);
        integer i;
        begin
            rx_line = 1'b0; #(BIT_PS);              // start
            for (i = 0; i < 8; i = i + 1) begin
                rx_line = b[i]; #(BIT_PS);
            end
            rx_line = 1'b1; #(BIT_PS);              // stop
        end
    endtask

    // ---- check 1: measure the narrowest edge-to-edge interval on the wire.
    // In UART framing the shortest possible pulse is exactly one bit time.
    real t_prev, t_now, delta, min_delta;
    reg  measuring = 0;
    initial begin
        min_delta = 1.0e18;
        t_prev    = 0.0;
        forever begin
            @(tx_line);
            if (measuring) begin
                t_now = $realtime;
                if (t_prev > 0.0) begin
                    delta = t_now - t_prev;
                    if (delta < min_delta) min_delta = delta;
                end
                t_prev = t_now;
            end
        end
    end

    integer i;
    reg [7:0] got, expect_b;
    real measured_baud;
    integer first_seed_at;
    reg [7:0] cap [0:NBYTES-1];

    initial begin
        // Power-on reset inside the DUT releases after ~32768 clocks.
        repeat (40000) @(posedge clk);

        // ---- check 0: the design is burst-on-demand, so the line must be
        // idle high until a command arrives. A busy line here means it has
        // reverted to free-running, which destroys receiver framing.
        if (tx_line !== 1'b1) begin
            $display("FAIL: uart_tx is not idle before any command was sent");
            errors = errors + 1;
        end

        // ---- check 4: RX command channel
        if (leds[3] !== 1'b1) begin
            $display("FAIL: rx_ever was already set before any byte was sent");
            errors = errors + 1;
        end
        // ---- checks 1 + 2 run concurrently with the capture below
        measuring = 1;
        counting  = 1;

        // The receiver MUST be armed before the command finishes going out.
        // uart_rx asserts rx_valid at the middle of the stop bit (~9.5 bit
        // times), and the burst's first start bit follows ~4 clocks later --
        // i.e. while send_byte is still blocked driving its own stop bit out
        // to t=10. Running these sequentially arms the capture ~0.5 bit times
        // too late and misframes every byte. A real host doesn't have this
        // problem: its UART is always listening and the OS buffers the bytes.
        //
        // ---- check 3: the burst is deterministic, so byte 0 must be SEED
        // exactly -- no searching for a sync point.
        fork
            begin : capture
                for (i = 0; i < NBYTES; i = i + 1) rx_byte(cap[i]);
            end
            begin : command
                send_byte(CMD_RESYNC);
            end
        join

        measuring = 0;
        counting  = 0;

        if (leds[3] !== 1'b0) begin
            $display("FAIL: RX command channel dead -- 0xAA did not set rx_ever (leds[3])");
            errors = errors + 1;
        end

        measured_baud = 1.0e12 / min_delta;
        $display("INFO: narrowest edge-to-edge = %.0f ps -> baud ~= %.0f (expected %0d)",
                 min_delta, measured_baud, BAUD);
        if (measured_baud < BAUD * 0.98 || measured_baud > BAUD * 1.02) begin
            $display("FAIL: uart_tx bit time is wrong on the wire: measured baud %.0f, expected %0d",
                     measured_baud, BAUD);
            errors = errors + 1;
        end

        $display("INFO: %0d byte launches, %0d LFSR advances", byte_launches, lfsr_advances);
        if (byte_launches == 0) begin
            $display("FAIL: design transmitted nothing at all");
            errors = errors + 1;
        end else if (lfsr_advances != byte_launches) begin
            $display("FAIL: LFSR advanced %0d times for %0d transmitted bytes (must be 1:1)",
                     lfsr_advances, byte_launches);
            errors = errors + 1;
        end

        expect_b = SEED;
        for (i = 0; i < NBYTES; i = i + 1) begin
            if (cap[i] !== expect_b) begin
                $display("FAIL: byte %0d mismatch: expected=0x%02x got=0x%02x (first 8 captured: %02x %02x %02x %02x %02x %02x %02x %02x)",
                         i, expect_b, cap[i],
                         cap[0], cap[1], cap[2], cap[3], cap[4], cap[5], cap[6], cap[7]);
                errors = errors + 1;
                i = NBYTES;
            end else begin
                expect_b = lfsr_next(expect_b);
            end
        end

        // ---- check 5: REAL mode, and resync restarting its source.
        // Drain the rest of the mock burst first -- the host protocol requires
        // draining before the next command (see CLAUDE.md), so the testbench
        // models a well-behaved host here rather than a racing one.
        wait_burst_done();

        // A mode byte selects the source for the *next* burst but does not arm
        // one; 0xAA does. Same fork/join reason as above: arm the capture
        // before the resync's stop bit finishes going out.
        send_byte(CMD_FORCE_REAL);
        fork
            begin : capture_real
                for (i = 0; i < NBYTES; i = i + 1) rx_byte(cap[i]);
            end
            begin : command_real
                send_byte(CMD_RESYNC);
            end
        join

        if (leds[1] !== 1'b1) begin
            $display("FAIL: 0x52 did not leave MOCK mode (leds[1] still lit)");
            errors = errors + 1;
        end
        for (i = 0; i < NBYTES; i = i + 1) begin
            if (cap[i] !== i[7:0]) begin
                $display("FAIL: REAL byte %0d mismatch: expected=0x%02x got=0x%02x (first 8 captured: %02x %02x %02x %02x %02x %02x %02x %02x)",
                         i, i[7:0], cap[i],
                         cap[0], cap[1], cap[2], cap[3], cap[4], cap[5], cap[6], cap[7]);
                errors = errors + 1;
                i = NBYTES;
            end
        end

        // Resync mid-burst, with the counter demonstrably non-zero (NBYTES
        // bytes have gone out). A complete 256-byte burst wraps an 8-bit
        // counter back to 0 on its own, so only a partial burst can tell a
        // real resync apart from doing nothing.
        if (dut.real_data_stub === 8'h00) begin
            $display("FAIL: testbench is not discriminating -- real_data_stub is already 0 before the mid-burst resync");
            errors = errors + 1;
        end
        snoop_en = 1'b1;
        send_byte(CMD_RESYNC);
        repeat (20) @(posedge clk);
        snoop_en = 1'b0;

        if (!resync_seen) begin
            $display("FAIL: mid-burst 0xAA never reached the design (do_resync never pulsed)");
            errors = errors + 1;
        end else if (real_at_resync !== 8'h00) begin
            $display("FAIL: resync did not restart the REAL source: real_data_stub=0x%02x after 0xAA, expected 0x00",
                     real_at_resync);
            errors = errors + 1;
        end

        if (errors == 0)
            $display("PASS: bringup_selftest top-level, baud + LFSR cadence + command channel + mock/real resync verified");
        else
            $fatal(1, "FAIL: %0d error(s)", errors);
        $finish;
    end

    // watchdog -- counted in clocks, not a #delay: the ~22ms ceiling this needs
    // does not fit in Verilog's default 32-bit unsized literal when expressed in ps.
    initial begin
        repeat (1_500_000) @(posedge clk); // ~55 ms at 27 MHz
        $display("FAIL: watchdog timeout");
        $fatal(1);
    end
endmodule
