davidg5678/HP-Prime-IPS-LCD-Mod-FPGA/(commit log)

2026-07-30 Bootstrap agentic FPGA dev environment (proto-phase-1)
    Headless build/sim/flash loop for the Tang Nano 20K, verified end-to-end this
    session: gw_sh (vendor, primary) and yosys/nextpnr-himbaechel/apycula
    (secondary sanity path) both produce working bitstreams from the same RTL,
    Icarus Verilog self-checking testbenches give sub-second PASS/FAIL feedback,
    and a runtime mock/real mux convention lets an agent validate hardware
    behavior without the real HP Prime attached. Fixed the GW2A/GW2AR device
    string bug in the original placeholder project.
    [bringup_selftest_top.v, lfsr8.v, serial_selftest.py, tb_uart_loopback.v, uart_rx.v, uart_tx.v]
2026-08-02 Fix proto-phase-1 hardware link: design was held in reset by MODE0 strap
    The Arduino bridge was never the problem. `rst` was mapped to pin 88, which
    is the GW2AR-18C's MODE0 configuration strap, not a GPIO. The board's
    strapping overrides the .cst's PULL_MODE=UP, so rst read low, rst_n stayed
    asserted, and uart_tx sat at its reset value (idle high) forever.
    This hid behind `heartbeat`, the one register declared `always @(posedge clk)`
    with no reset term: leds[0] kept blinking while everything else was frozen, so
    every "the bitstream is alive" check was true and meaningless at the same time.
    Last session's 3.4V reading on pin 72 corroborated it and was misread -- a pin
    actively streaming UAR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
    [bringup_selftest_top.v, serial_selftest.py, tb_bringup_selftest.v]
2026-08-02 proto-phase-1 COMPLETE: BL616 UART at 1 Mbaud, Arduino bridge removed
    The onboard BL616 UART was never broken. Previous sessions attributed the
    silence on pins 69/70 to macOS's AppleUSBFTDI driver and built an Arduino Uno
    bridge to route around it; in fact the FPGA was held in reset (pin 88 = MODE0
    config strap), so every path was equally silent.
    With the internal POR in place, uart_rx->pin 70 / uart_tx->pin 69 worked on the
    first try. Baud raised to 1,000,000 (27 MHz / 1 MBaud = DIV 27, zero division
    error, vs +0.16% at 115200), verified in simulation at 1000028 baud on the wire
    before flashing. make selftest-hw passes 5/5 consecutive runs, 256 bytes, 0
    errors, mock/real mux verified over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
    [bringup_selftest_top.v, serial_selftest.py, tb_bringup_selftest.v]
2026-08-02 Close proto-phase-1 leftovers: timing constraints, deterministic resync
    1. Add src/targets/bringup_selftest/bringup_selftest.sdc. gowin_build.sh
    already auto-included <target>.sdc, so this needed no script change. Without
    it gw_sh ran NO timing analysis and reported zero violations because it
    checked zero paths -- the silent-success failure mode docs/verification.md
    is about. With it: 351 paths, 0 setup / 0 hold violations, Fmax 205.4 MHz
    against the 27 MHz constraint, agreeing with nextpnr's independent ~248 MHz.
    WARN (TA1132) is gone.
    The remaining WARN (PR1014) is now explained rather than tolerated: pin 4's
    Function column reads LPLL1_T_in -- it is the left PLL's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
    [bringup_selftest_top.v, tb_bringup_selftest.v]
2026-08-02 Bring PROGRESS.md current through 602b37c
    The top entry predated the timing-constraint / deterministic-resync commit,
    so the file still listed the missing .sdc and the CMD_RESYNC real_data_stub
    gap as open items after both had been fixed. Adds the part-3 entry and
    carries forward the three items that are genuinely still open (leds[4]
    unread, pin 87 unchecked, verilator lint noise floor).
2026-08-03 Phase 1: logic analyser capturing, triggering and draining on hardware
    New target `la_capture`: 12 channels sampled at 108 MHz into 32768 samples of
    BSRAM, mask/value trigger with selectable EDGE or LEVEL semantics, pre-trigger
    history, and a windowed drain over the same 1 Mbaud BL616 link proto-phase-1
    established. Follows the runtime mock/real mux convention -- a synthetic
    serial-RGB generator and the physical probe pins are both in the one bitstream.
    Verified end to end on the board:
    make capture-hw -> PASS, 24577 samples, DOTCLK period + HSYNC period +
    DE width + RGB pattern all checked against the generator's parameters.
    Gowin signoff: 4357 paths, 0 setup / 0 hold, Fmax 160.8 MHz a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
2026-08-03 Re-map probe pins around the RGB LCD connector; identify the Prime's flex
    The scope survey in docs/"HP Prime LCD Pinout.xlsx" identifies the HP Prime's
    45-pin LCD flex, and the arithmetic closes:
    flex 7 DE 9.8 kHz bursts, 24.7 ms on / 1.96 ms off
    flex 8 VSYNC 37.7 Hz
    flex 9 HSYNC 9.61 kHz
    flex 10 DOTCLK 13.1 MHz
    flex 11-18 D0-D7
    Frame 26.53 ms / line 104.1 us = 254.9 lines. Pin 7's envelope is the vertical
    structure -- 237 active lines + 18.8 blanking = 256.2, agreeing within scope
    precision, and only DE has that shape. ~240 active of 255 is a 320x240 panel,
    which is the Prime's display. 1363 DOTCLKs per line.
    Twelve consecutive flex pins for twelve channels --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
    [HP Prime LCD Pinout.xlsx]
2026-08-03 Analyse the AFY320240A0 panel: no adapter needed, but no passthrough either
    Orient Display AFY320240A0-3.5INTH-C2 (docs/AFY320240A0-3.5INTH-C2-spec.pdf),
    3.5" 320x240 -- an exact resolution match for the HP Prime -- ST7272A driver,
    parallel RGB 24-bit, 3.3 V logic. Analysis only, no code change.
    ADAPTER: not needed for the video path. Checked pin-by-pin against the
    schematic's DISPLAY sheet, the panel's 40-pin 0.5 mm FPC matches the Tang
    Nano's on 38 of 40 pins -- power, all colour lines, DOTCLK, HSYNC, VSYNC, DE,
    DISP and backlight. The two that differ are benign: the board grounds pin 36
    (SDA) and leaves pin 35 (SCL) NC, but the panel specifies pin 3 (CS) as
    "Ground" and the board does th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
2026-08-03 Verify the channel map end-to-end; add a per-channel probe check
    Two additions ahead of the first real capture, both aimed at the same risk:
    that a probe is not on the channel we think it is.
    1. python/tools/la_capture.py --probe-check: per-channel transition count,
    estimated frequency, duty and narrowest pulse. A channel's frequency
    identifies it on its own -- DOTCLK, HSYNC and DE are orders of magnitude
    apart -- so this turns "did I wire twelve fine wires correctly" into one
    command. Validated against MOCK, where the answers are known: it reports
    DOTCLK 13.50 MHz (= 108/8 exactly) and HSYNC 114 kHz (= 13.5 MHz/120).
    2. A walking-1 channel-mapping check in the testbench, be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
    [la_capture.py, tb_la_capture.v]
2026-08-03 First real capture: the HP Prime's LCD bus is decoded
    Probes connected, all 12 channels live on first try, and the interface is now
    characterised from real silicon rather than inferred.
    DOTCLK 13.289 MHz, 75.25 ns period, ~53% duty
    clocks per pixel 3 -- 960 DOTCLKs per DE run / 320 = exactly 320.00 px
    line 102.435 us (9.762 kHz), 1361 DOTCLKs = 960 active + 401 blank
    HSYNC active low, ~1 DOTCLK wide (74 ns)
    DE active high, 72.25 us
    VSYNC active low, 37.7 Hz
    data changes on the DOTCLK falling edge; latch on the rising edge
    blanking bus driven to 0x00
    content greyscale: R = G = B for all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
2026-08-03 Component order is R, G, B; stop failing on coloured captures
    A red screen on the Prime captured as 320 px of ff 00 00 on every line, so the
    first byte of each triplet is RED: component order R, G, B.
    Unambiguous because the triplet phase was already pinned independently from the
    greyscale captures -- 960 DOTCLKs per DE run dividing to exactly 320.00 pixels
    at sampling offset 0. With the phase fixed, the first byte after DE rises is
    the first component, and saturated red puts 0xff there.
    The Prime's LCD protocol is now completely specified:
    320x240, serial RGB, 3 DOTCLKs per pixel, order R G B
    DOTCLK 13.289 MHz, ~53% duty; data changes on the falling edge,
    latch on the ri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
    [decode_prime.py]
2026-08-03 Confirm component order with a second single-colour capture
    Green screen captures as 00 ff 00 on all 320 px of all three lines, isolating
    the middle component. Together with the red screen (ff 00 00) that is two
    independent confirmations, each pinning a different component:
    red -> ff 00 00 => component 0 is RED
    green -> 00 ff 00 => component 1 is GREEN
    therefore component 2 is BLUE, by elimination over a 3-component pixel
    A blue capture would be redundant. Both PPMs round-trip exactly -- 320x3,
    960 px, every pixel (255,0,0) and (0,255,0) -- so the decoder, the triplet
    grouping and the PPM writer are all verified end to end against known ground
    truth rather than against each other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
2026-08-03 Document the reverse-engineered HP Prime LCD protocol
    docs/prime_lcd_protocol.md: the complete measured specification, with the
    provenance of every figure and the evidence behind each conclusion. Nothing in
    it is taken from a datasheet or assumed from family resemblance; where a number
    comes from the oscilloscope rather than the logic analyser, it says so.
    320x240, 8-bit bus, serial RGB, 3 DOTCLKs per pixel, order R G B
    DOTCLK 13.289 MHz, 75.25 ns, ~53% duty
    line 1361 DOTCLKs = 102.435 us = 9.762 kHz
    242 back porch (incl. 1-DOTCLK HSYNC pulse) + 960 active + 159 front
    frame 259 lines = 26.53 ms = 37.70 Hz (240 active + 19 blanking)
    data changes on the falling e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
2026-08-03 Fix a sentence split by the previous doc cross-reference
    The pointer to prime_lcd_protocol.md was inserted mid-sentence in CLAUDE.md,
    orphaning the device string and the phase overview. Moved to its own paragraph
    after the intro.
2026-08-03 SDRAM investigation: the SIP pin mapping is free, so we write our own controller
    Establishes the facts needed before any RTL, from the GW2AR data sheet the user
    added (docs/Gowin FPGA IC Docs.pdf) plus two experiments against gw_sh.
    THE PART. System-in-package, not a board component -- it appears nowhere on the
    Tang Nano schematic. SDR SDRAM, 64 Mbit / 8 MB, 32 bits wide, organised as
    4 banks x 2048 rows x 256 columns x 32 bits, max 166 MHz, CAS latency 2 or 3,
    one AUTO REFRESH every 15.625 us (4096 cycles / 64 ms). The geometry is
    confirmed independently by Gowin's SDRC_EMB IP defines.
    THE PIN MAPPING, determined by experiment because it is documented nowhere: no
    .cst template ships with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
2026-08-03 SDRAM controller working: 8 MB written and verified on hardware
    make sdram-hw -> PASS: SDRAM self-test, 2,097,152 words (8 MB) written and
    verified, 0 errors. 5/5 consecutive runs, 0.52 s per full write+readback pass
    (30.7 MB/s). Gowin signoff 2537 paths, 0 setup / 0 hold. All 55 SDRAM ports
    bonded to internal p pads with zero package pins consumed, confirmed from the
    placed design.
    Adds sim/models/sdram_sim.v, src/common/sdram_ctrl.v,
    src/targets/sdram_selftest/, two sim targets, python/tools/sdram_selftest.py
    and a make sdram-hw target.
    THE CLOCK PHASE WORKED FIRST TIME. docs/sdram.md flagged O_sdram_clk phase as
    the most likely cause of "simulates perfectly, reads garbage from silicon".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
    [sdram_ctrl.v, sdram_selftest.py, sdram_selftest_top.v, sdram_sim.v, tb_sdram_ctrl.v, tb_sdram_selftest.v]
2026-08-03 Whole-frame capture: 320x240 of the Prime's screen, through SDRAM
    make frame-hw -> PASS: frame captured and decoded, 240 lines of 320 pixels,
    130 runt edges rejected in hardware. A complete frame of the calculator's
    display, captured into SDRAM and decoded into an image.
    The decoded frame is plainly the Prime's home screen: 613 distinct colours,
    74% white, row 0 a uniform 25 62 a8 (the blue title bar), rows alternating
    between 1 distinct colour and 20-48 as blank lines and text glyphs, 88.7%
    greyscale with the remainder blues.
    THE BANDWIDTH ARITHMETIC CHOSE THE ARCHITECTURE -- AND CHOSE WHAT NOT TO BUILD.
    The obvious move after the SDRAM worked was burst mode. The numbers said no:
    overs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
2026-08-03 Live screen streaming: RLE over SDRAM, first frame complete at ~2 fps
    make stream-hw -> PASS: live stream, 8 frames decoded at 2.56 fps, 0 truncated.
    The first frame of every run is a complete 320x240 (76,800 px); later frames
    arrive but are partial. Root cause not yet found and documented as open rather
    than papered over.
    Adds src/common/pixel_rle.v, src/targets/frame_stream/,
    sim/targets/frame_stream/, python/tools/frame_stream.py, make stream-hw.
    All seven simulations pass.
    MEASUREMENT DECIDED EVERY PART OF THE DESIGN.
    raise the baud rate? No. 3 Mbaud gives 79 KB/s and 1 Mbaud 81 KB/s --
    per-request latency (~74 ms per 8 KB) dominates, not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
2026-08-04 Phase 3 panel driver running on hardware; Phase 4 passthrough passes in sim
    make lcd-hw -> PASS: lcd_panel emitting 320x240 in 371x260 at 62.2 Hz, on real
    silicon, first flash. The panel itself still displays nothing, and the cause is
    outside the FPGA: its FFC and the board's J2 are opposite contact types (A vs
    B), confirmed with a multimeter, so nothing mates. Blocked on a reversing FFC.
    Adds src/common/{lcd_timing_gen,test_pattern,prime_pixel,ws2812_off}.v,
    src/targets/{lcd_panel,passthrough}/, sim/targets/{lcd_timing_gen,lcd_panel,
    prime_pixel,passthrough}/, python/tools/lcd_panel.py, make lcd-hw.
    All eleven simulations pass.
    THE FPGA SIDE IS RIGHT, MEASURED TWO INDEPENDENT WAYS.
    h =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
    [lcd_panel.py, lcd_panel_top.v, lcd_timing_gen.v, passthrough_top.v, prime_pixel.v, tb_lcd_panel.v]
2026-08-04 Phase 3 complete: the panel is displaying
    The Orient Display AFY320240A0 is lit and showing all eight test patterns at
    320x240. make lcd-hw -> PASS: lcd_panel emitting 320x240 in 371x260 at 62.2 Hz.
    The fix was a reversing (type A <-> type B) 40-pin 0.5 mm FFC. Nothing in the
    FPGA changed. That was the one pre-flight check docs/panel_afy320240a0.md had
    flagged as impossible to settle from the schematic, and it was the only thing
    wrong.
    WHAT A WORKING PANEL CONFIRMS THAT NOTHING ELSE COULD.
    connector bit order (descending pin number as vector index ascends) -- would
    otherwise have shown as plausible-looking wrong colours
    RGB565 channel wiring, all three channels
    DE gating and the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
    [lcd_panel_top.v]
2026-08-04 Phase 4 complete: the HP Prime's screen is live on the replacement panel
    Worked on the first hardware attempt. The calculator's display is reproduced
    on the Orient Display AFY320240A0 in real time, entirely inside the FPGA --
    the host is not in the video path at all. All four phases are now done.
    make pass-hw -> PASS: passthrough emitting 320x240 in 371x260 at 62.2 Hz
    (62.7 fps wall-clock); source 320x240 at 18.9 fps, LIVE PASSTHROUGH
    AUTO mode, and why the default changed
    --------------------------------------
    Phase 4's deliverable is a standalone box -- calculator in, panel out, no
    computer -- and CLAUDE.md's mock-mode convention (default MOCK, switch via
    UART) meant a flashed board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
    [passthrough.py, passthrough_top.v, tb_passthrough.v]
2026-08-04 Triple buffer: full 37.7 fps passthrough, plus a 19x faster sim loop
    Hardware: source 18.9 fps -> 37.4 fps. Every source frame is now captured.
    The flashed board boots into the live passthrough with its own backlight and
    needs no host at all.
    Triple buffering
    ----------------
    Two buffers dropped every other frame. The shipped argument -- "the reader is
    strictly faster than the writer, so a completed capture is always collected
    before the writer needs the buffer back" -- is true and insufficient:
    reader-faster-than-writer guarantees a capture is COLLECTED in time; it does
    not make a buffer AVAILABLE at the instant the writer wants one. ev_done lands
    on the same clock as the next src_frame_st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
2026-08-05 Runtime PWM frequency for backlight dimming; make simq-all; fix a 32-bit literal overflow
    Backlight: the "PWM dimming does not work" claim was over-fitted
    ----------------------------------------------------------------
    What was actually measured is ONE point: 1 kHz, 25% duty, 250 us of on-time.
    That got written into three documents as a property of the board. The relation
    that governs it is
    minimum usable duty ~= converter soft-start / PWM period
    so the frequency is a free variable that had never been moved. The same 25%
    duty at 200 Hz gives 1251 us -- five times the on-time -- and the LP3320's
    soft-start figure is not in hand.
    The PWM frequency is now runtime-settable (0x46, prescal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
    [passthrough.py, passthrough_top.v, tb_bringup_selftest.v, tb_passthrough.v]
2026-08-07 Backlight dimming works at 200 Hz; retract the "PWM dimming is impossible" claim
    Observed on hardware: at 200 Hz the backlight dims smoothly from duty 255 down
    to 8 and looks good at every level, with no flicker reported. At the bottom of
    the range the panel is dim but still lit.
    make pass-hw BLHZ=200 SWEEP=1
    duty % on-time
    255 100% 4988 us bright
    128 50% 2503 us | smooth, good at every step
    64 25% 1251 us |
    8 3% 156 us dim, still lit
    What this overturns
    -------------------
    Three documents carried "PWM dimming does not work on this board", generalised
    from a single measurement at 1 kHz / 25% duty. That is false as a s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
2026-08-29 Rewrite README: getting-started guide + transcribed pinout tables
    Expand the 14-line stub into a proper entry point: a phase-status summary,
    repo layout, hardware list, a 7-step getting-started (install, check-env,
    simq-all as the gate, build, flash, standalone passthrough, per-phase
    hardware checks), and four pinout tables — Prime flex danger pins,
    flex->probe wiring, panel 40-pin FFC, UART/BL616/reset. Pin data is
    transcribed from boards/tangnano20k/pinout.md, which stays the
    authoritative source.
    Claude-Session: https://claude.ai/code/session_01FAnp1EJZFWZkd4yt9U5tz4
